benvonhandorf/esp32_sensor_board/hardware/USB4510-03-1-A_REVA/USB4510-03-1-A_REVA.step

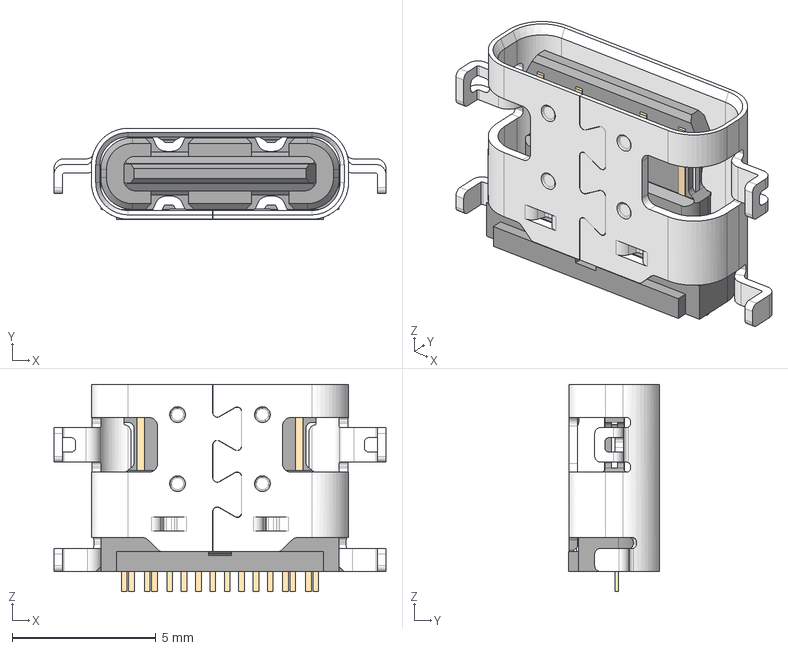
[picture p7: CAD file, 2024-07-11]
hardware/USB4510-03-1-A_REVA/USB4510-03-1-A_REVA.step
11.5 x 3.18 x 7.20 mm
