benvonhandorf/esp32_sensor_board/hardware/v0/esp32_sensor_board/info/esp32_sensor_board.pdf

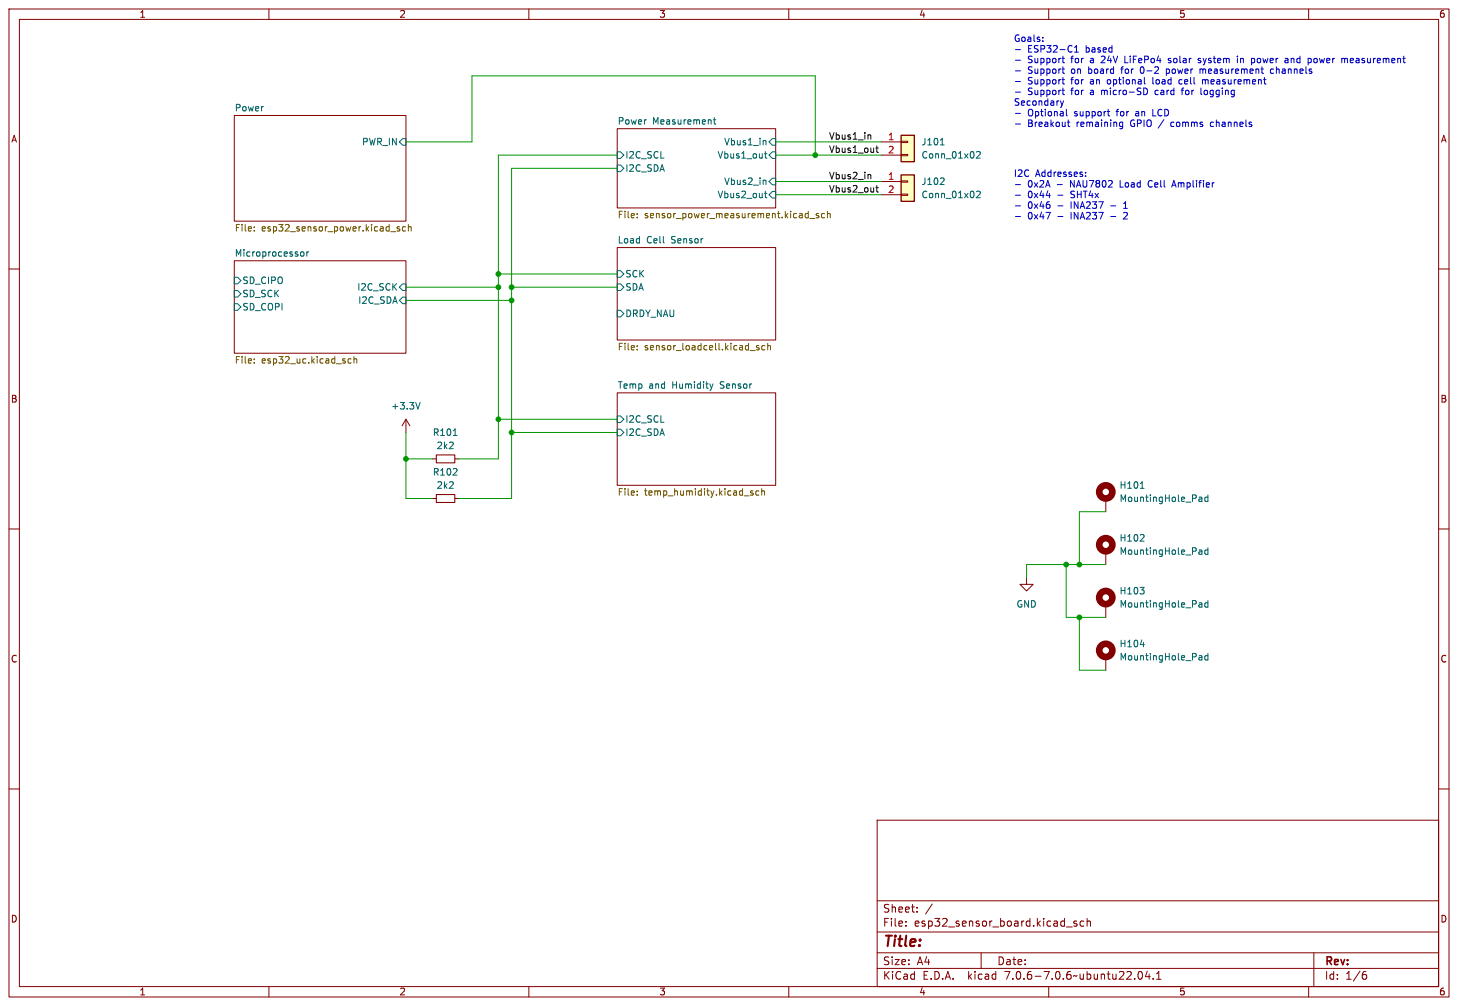
[picture p10: page 1]

I2C Addresses: - 0x2A - NAU7802 Load Cell Amplifier

Load Cell Sensor File: sensor_loadcell.kicad_sch

Id: 1/6 Title: File: esp32_sensor_board.kicad_sch Sheet: /

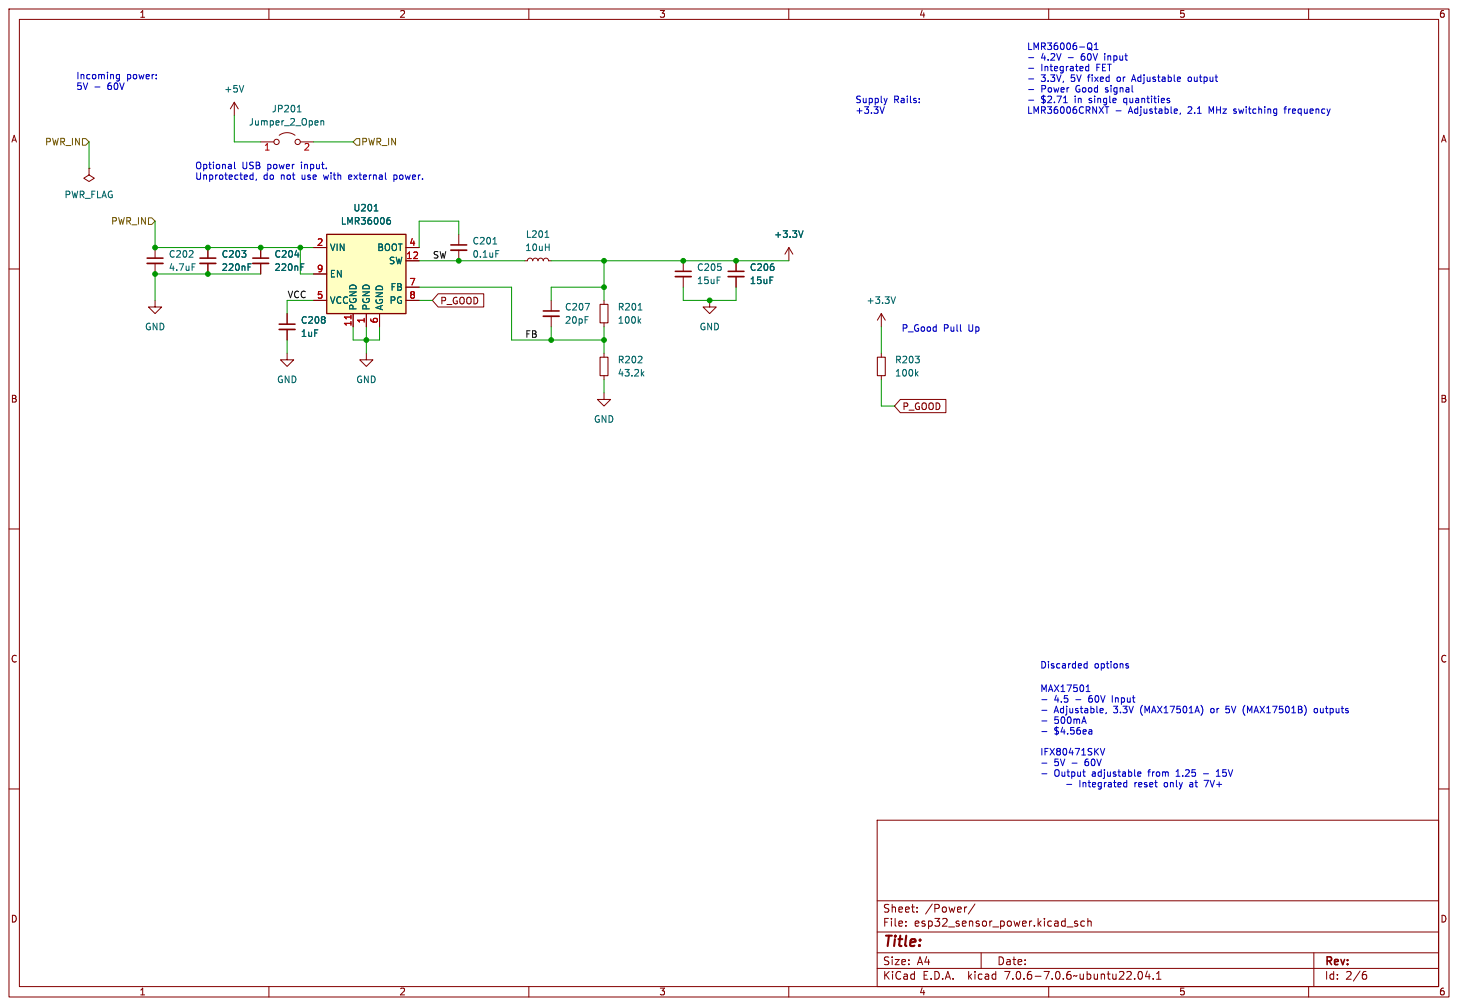
[picture p11: page 2]

1 PGND 11 SW 12 VIN 2 BOOT 4 VCC 5 AGND

Id: 2/6 Title: File: esp32_sensor_power.kicad_sch Sheet: /Power/

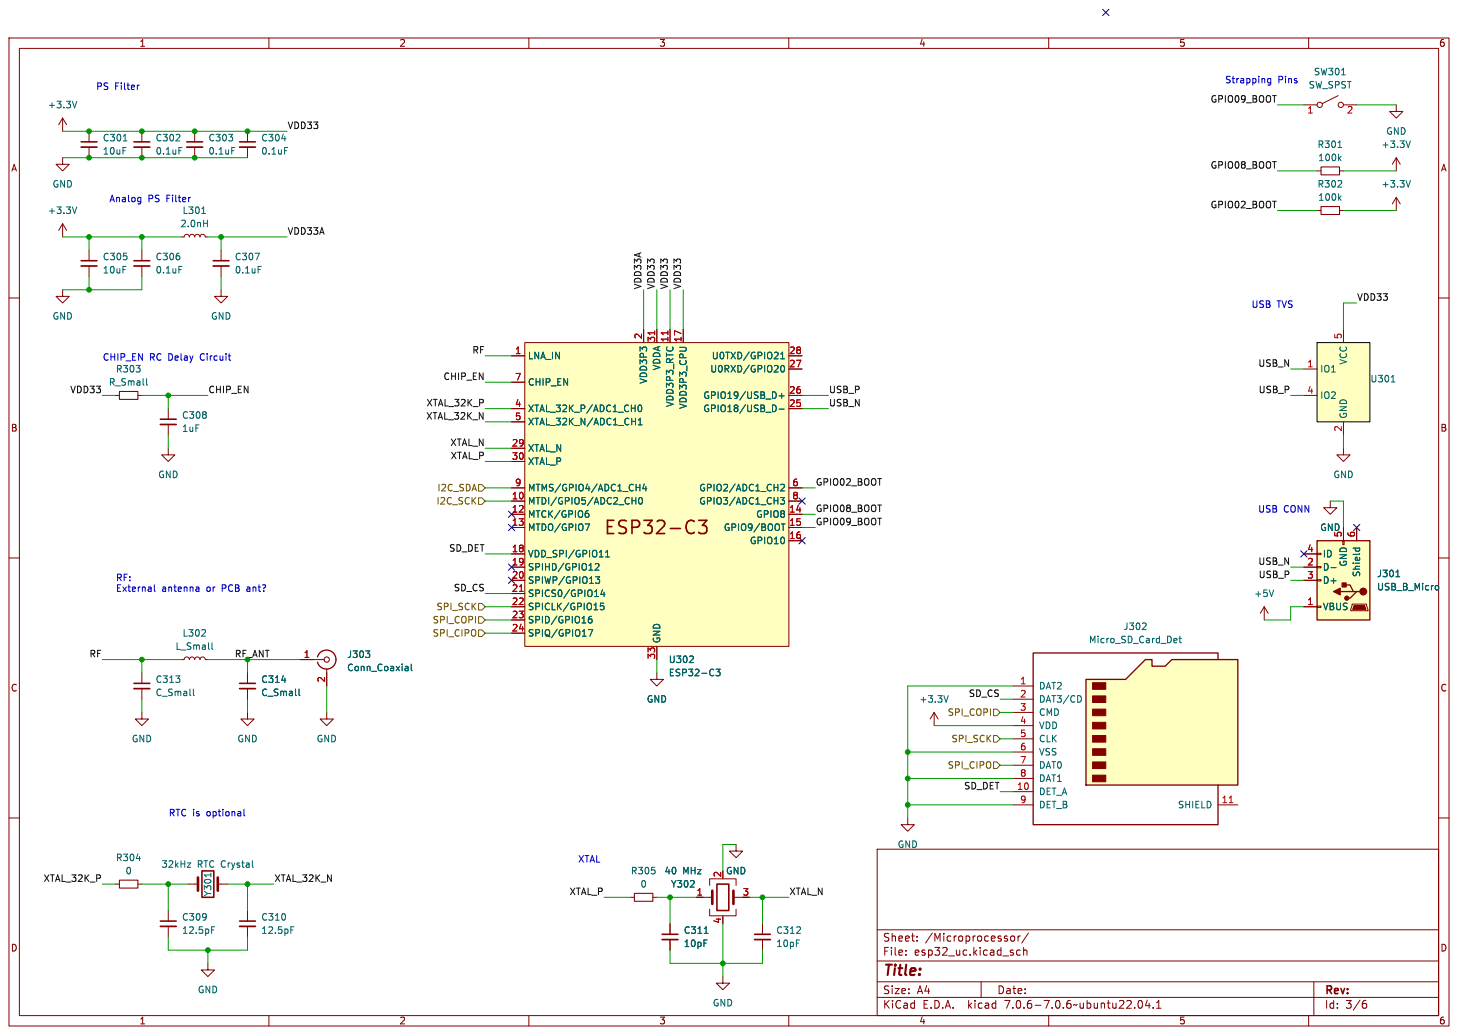
[picture p12: page 3]

2 SPIWP/GPIO13 20 SPICS0/GPIO14 21 SPICLK/GPIO15 22 SPID/GPIO16 23 SPIQ/GPIO17 24 GPIO18/USB_D- 25 GPIO19/USB_D+ 26 U0RXD/GPIO20 27 U0TXD/GPIO21 28 XTAL_N 29 XTAL_P 30 VDDA 31 GND 33 XTAL_32K_P/ADC1_CH0 4 XTAL_32K_N/ADC1_CH1 5 GPIO2/ADC1_CH2 6 CHIP_EN 7 GPIO3/ADC1_CH3 8 MTMS/GPIO4/ADC1_CH4 9 U302 ESP32-C3 GND

2 SPIWP/GPIO13 20 SPICS0/GPIO14 21 SPICLK/GPIO15 22 SPID/GPIO16 23 SPIQ/GPIO17 24 GPIO18/USB_D- 25 GPIO19/USB_D+ 26 U0RXD/GPIO20 27 U0TXD/GPIO21 28 XTAL_N 29 XTAL_P 30 VDDA 31 GND 33 XTAL_32K_P/ADC1_CH0 4 XTAL_32K_N/ADC1_CH1 5 GPIO2/ADC1_CH2 6 CHIP_EN 7 GPIO3/ADC1_CH3 8 MTMS/GPIO4/ADC1_CH4 9 GND

Id: 3/6 Title: File: esp32_uc.kicad_sch Sheet: /Microprocessor/

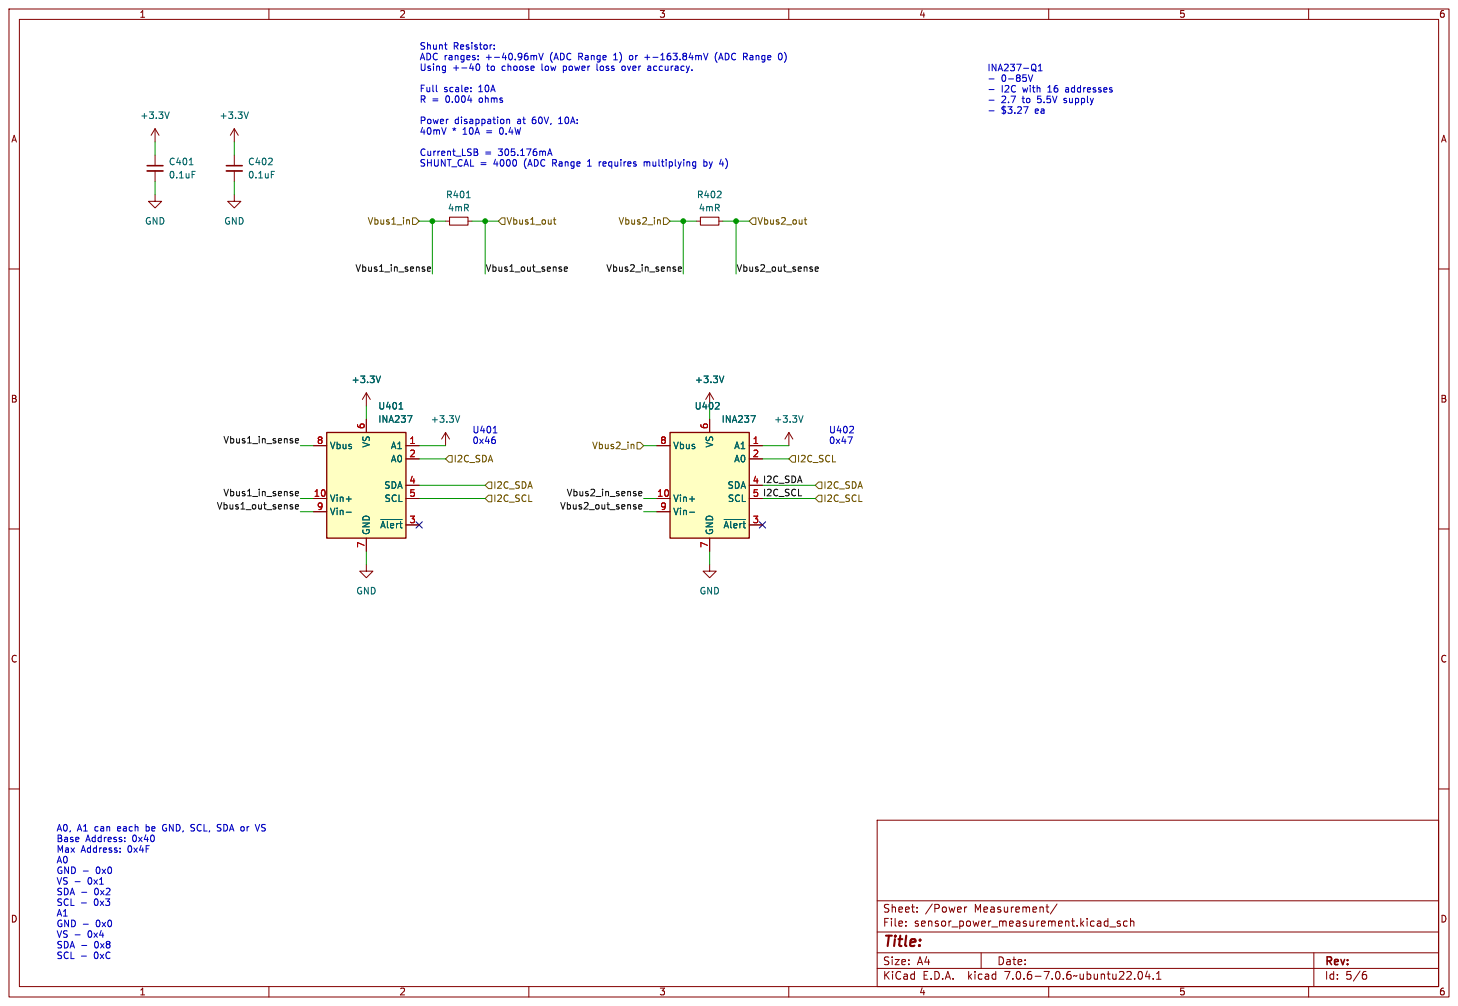
[picture p13: page 4]

0x47 A0, A1 can each be GND, SCL, SDA or VS

Base Address: 0x40 Max Address: 0x4F A0GND - 0x0 VS - 0x1 SDA - 0x2 SCL - 0x3 A1GND - 0x0 VS - 0x4 SDA - 0x8 SCL - 0xC

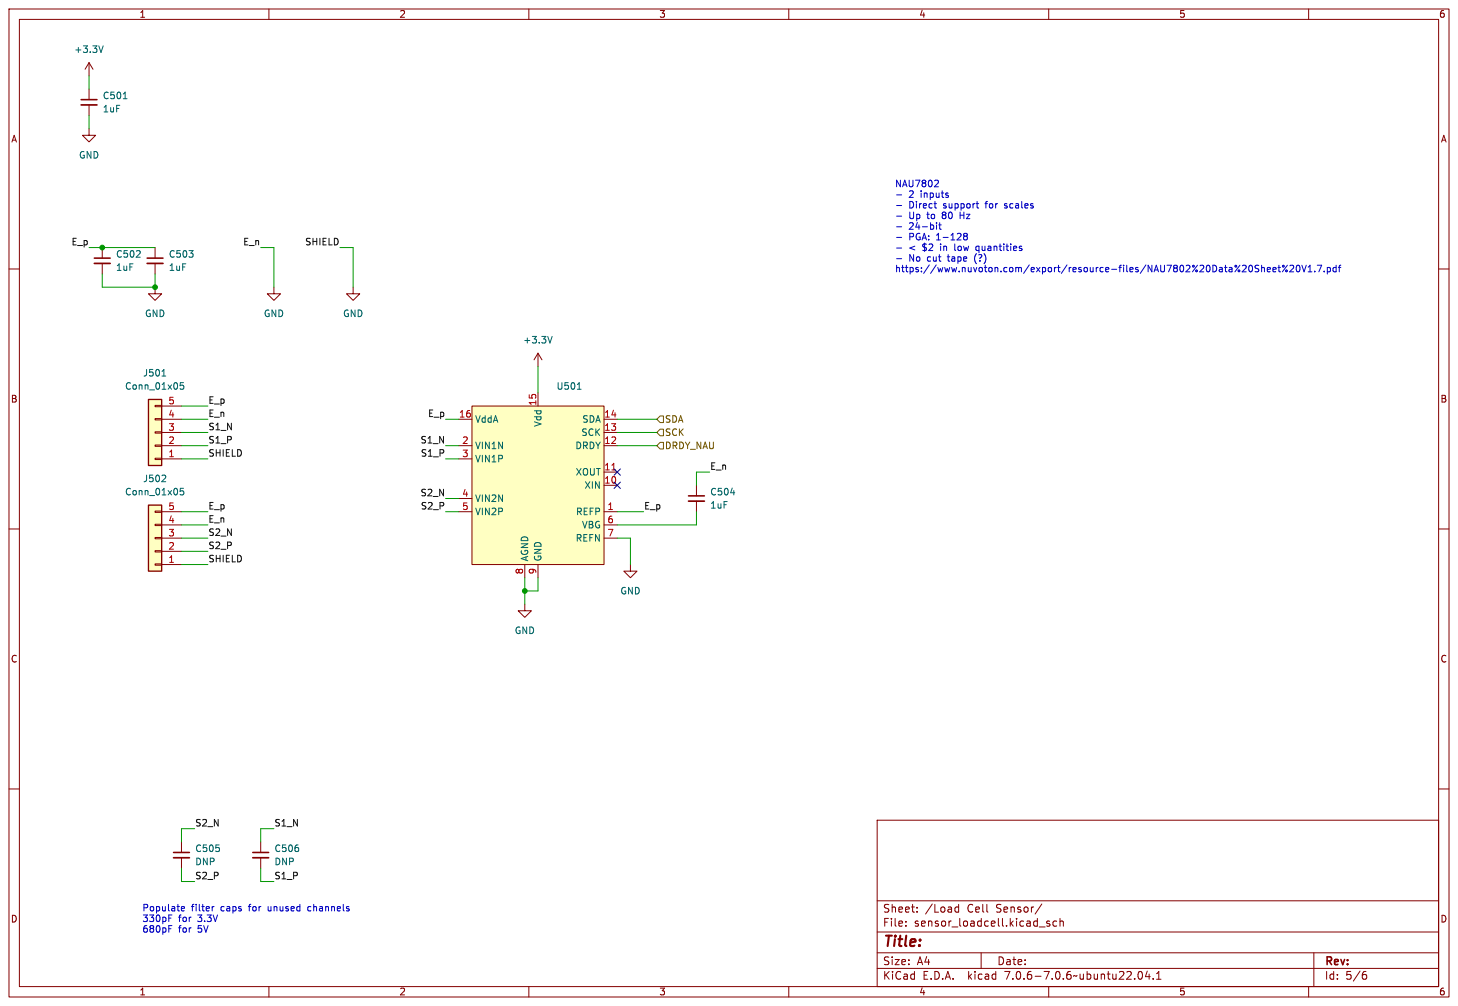
[picture p14: page 5]

NAU7802
- 2 inputs
- Direct support for scales
- 24-bit - PGA: 1-128

- < $2 in low quantities
- No cut tape (?)
https://www.nuvoton.com/export/resource-files/NAU7802%20Data%20Sheet%20V1.7.pdf

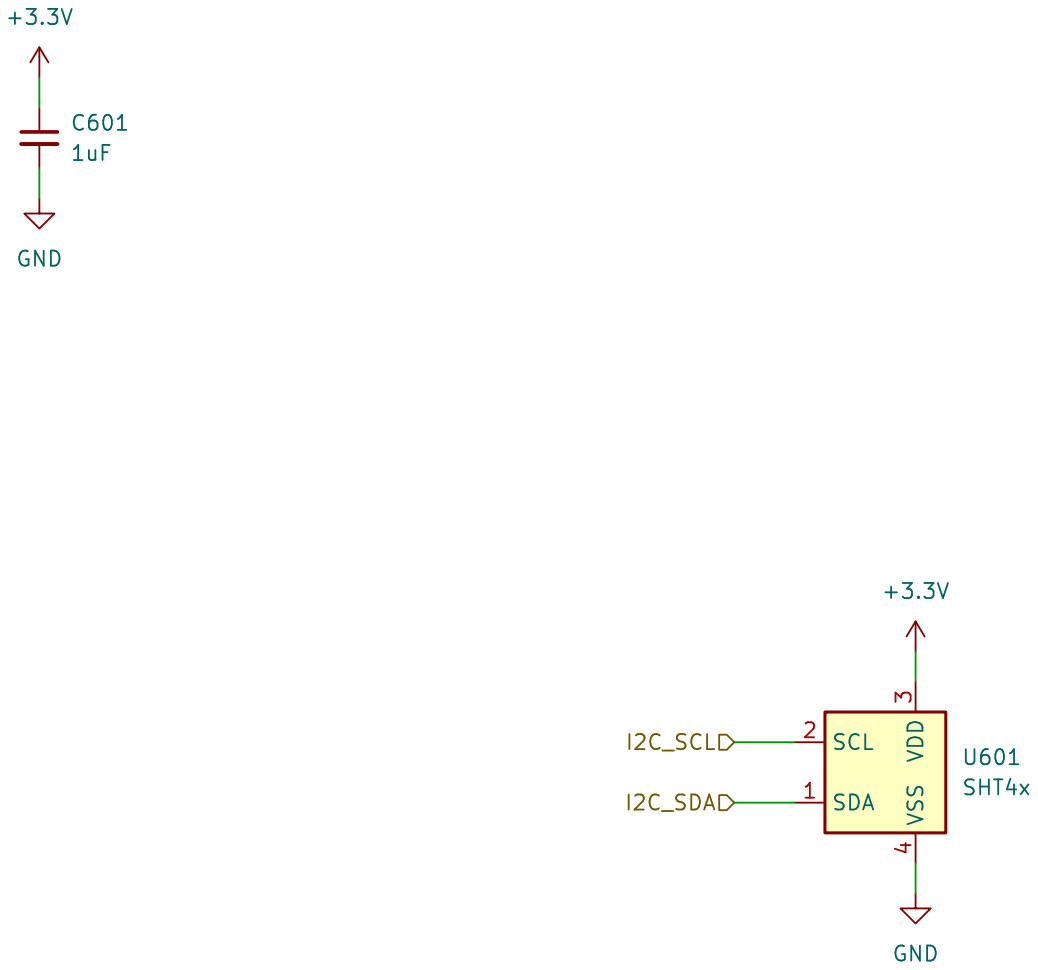
[picture p15: page 6]
