benvonhandorf/esp32_sensor_board/hardware/v1 - S3 - Mic Focus/pdm_mic_board_individual/pdm_mic_board_individual.kicad_pcb

## KiCad design hardware/v1 - S3 - Mic Focus/pdm_mic_board_individual/pdm_mic_board_individual.kicad_pcb (2026-09-26)

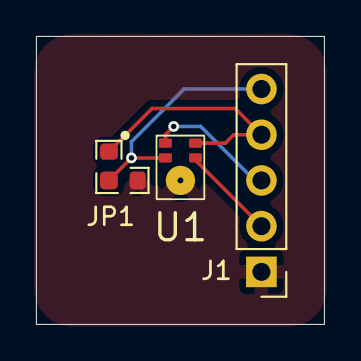
[picture p16: board pdm_mic_board_individual.kicad_pcb from above]

Board: 2 copper layers, 16.0 x 16.0 mm, 3 parts (0 on the bottom side), 5 nets.

Parts:
J1: Mic Conn; PinHeader_1x05_P2.54mm_Vertical
JP1: L/R; Jumper_Resistor_0603_2_Way
U1: Knowles_PDM_SMD_ThroughPort

Connections:
+3.3V: J1.4, JP1.1 (A), U1.5 (Vcc)
/Dout: J1.3, U1.1 (Dout)
/SCLK: J1.2, U1.4 (CLK)
/SEL: J1.5, JP1.2 (COM), U1.2 (SEL)
GND: J1.1, JP1.3 (B), U1.3 (GND)
