benvonhandorf/esp32_sensor_board/hardware/v1 - S3 - Mic Focus/s3_sensor_board/s3_sensor_board.kicad_pcb

## KiCad design hardware/v1 - S3 - Mic Focus/s3_sensor_board/s3_sensor_board.kicad_pcb (2026-09-26)

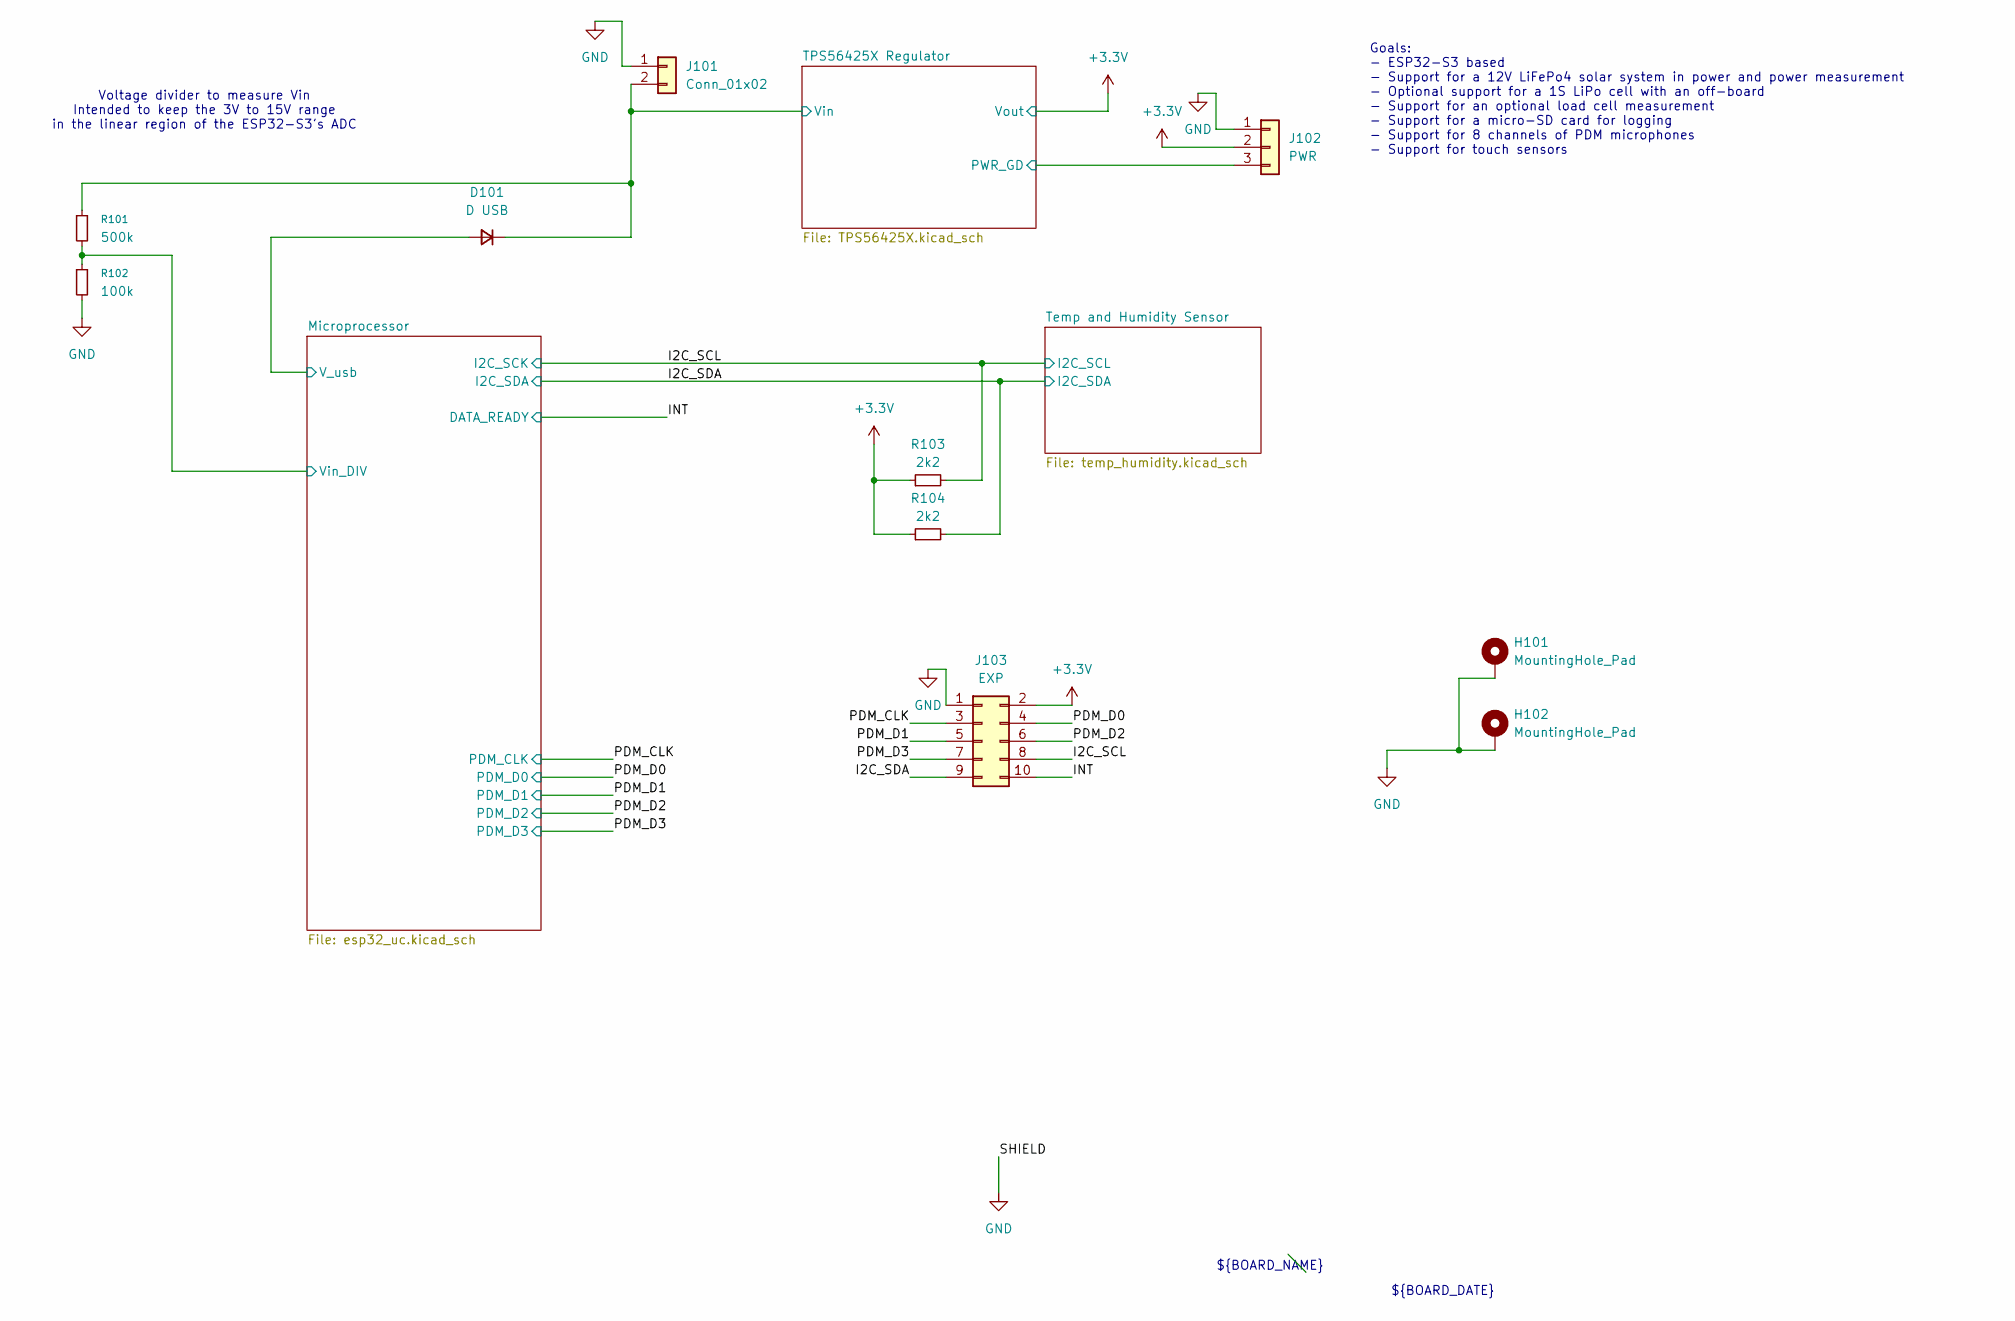
[picture p17: schematic s3_sensor_board.kicad_sch]

Parts:
D101: D USB; D_SOD-123
H101, H102: MountingHole_Pad; MountingHole_2.2mm_M2_DIN965_Pad
J101: Conn_01x02; PinHeader_1x02_P2.54mm_Vertical
J102: PWR; PinHeader_1x03_P2.54mm_Vertical
J103: EXP; IDC-Header_2x05_P2.54mm_Vertical
R101: 500k; R_0603_1608Metric
R102: 100k; R_0603_1608Metric
R103, R104: 2k2; R_0603_1608Metric

Connections:
+3.3V: J102.2, J103.2, R103.1, R104.1; also elsewhere on the board
/I2C_SCL: J103.8, R103.2; also elsewhere on the board
/I2C_SDA: J103.9, R104.2; also elsewhere on the board
/INT: J103.10; also elsewhere on the board
/Microprocessor/V_usb: D101.2 (A); also elsewhere on the board
/Microprocessor/Vin_DIV: R101.2, R102.1; also elsewhere on the board
/PDM_CLK: J103.3; also elsewhere on the board
/PDM_D0: J103.4; also elsewhere on the board
/PDM_D1: J103.5; also elsewhere on the board
/PDM_D2: J103.6; also elsewhere on the board
/PDM_D3: J103.7; also elsewhere on the board
/TPS56425X Regulator/PWR_GD: J102.3; also elsewhere on the board
/TPS56425X Regulator/Vin: D101.1 (K), J101.2, R101.1; also elsewhere on the board
GND: H101.1 (1_1), H102.1 (1_1), J101.1, J102.1, J103.1, R102.2; also elsewhere on the board

Notes on the sheet:
${BOARD_DATE}
Goals: - ESP32-S3 based - Support for a 12V LiFePo4 solar system in power and power measurement - Optional support for a 1S LiPo cell with an off-board - Support for an optional load cell measurement - Support for a micro-SD card for logging - Support for 8 channels of PDM microphones - Support for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
${BOARD_NAME}
Voltage divider to measure Vin Intended to keep the 3V to 15V range in the linear region of the ESP32-S3's ADC

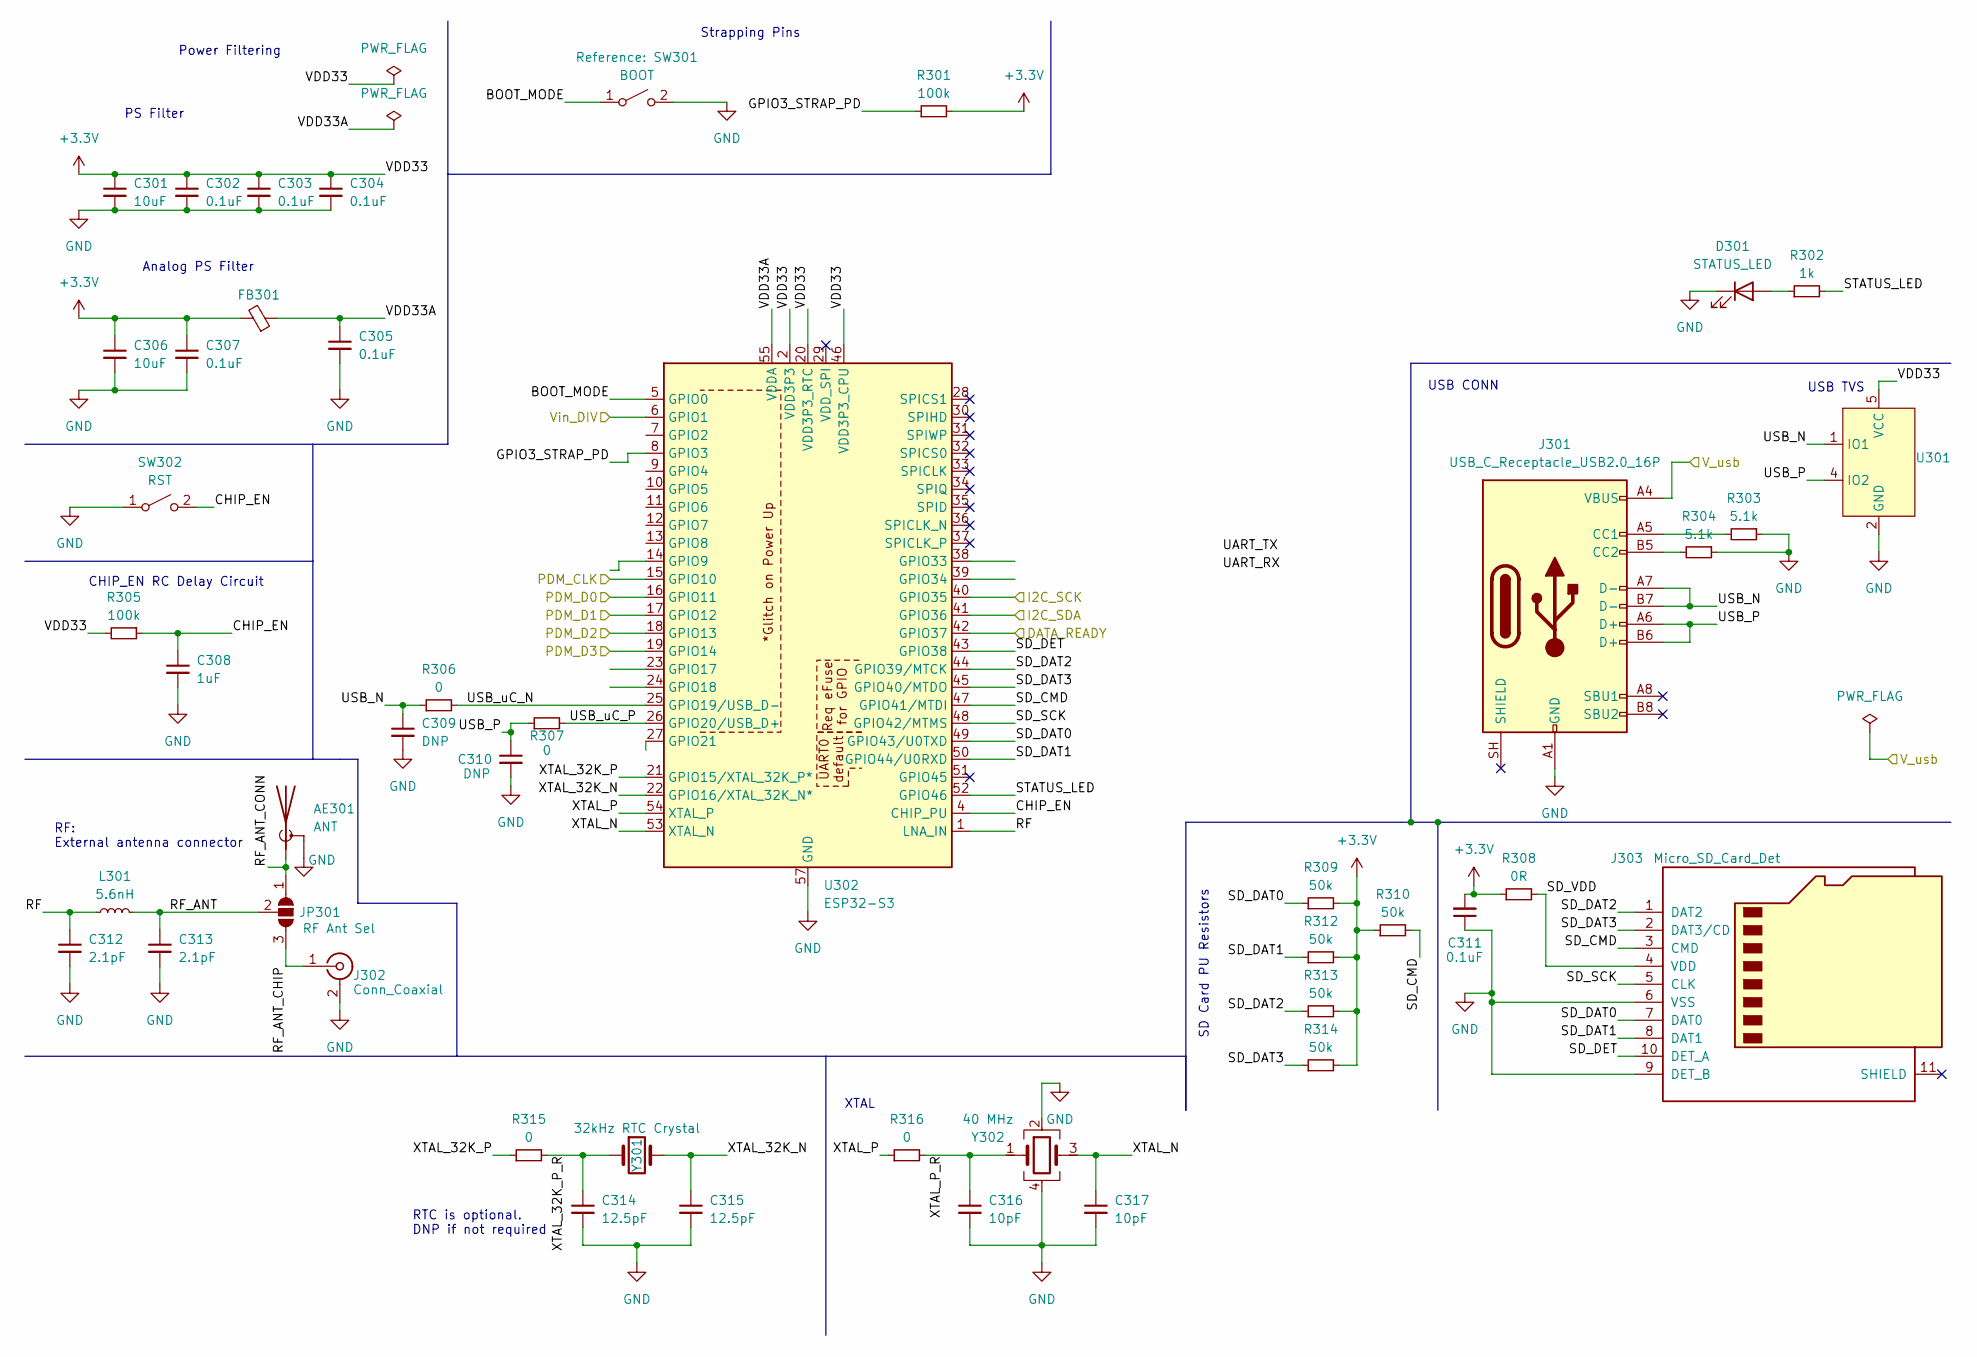
[picture p18: schematic esp32_uc.kicad_sch]

Parts:
AE301: ANT; ANT2012LL13R2400A
C301, C306: 10uF; C_0805_2012Metric
C302, C303, C304, C305, C307, C311: 0.1uF; C_0603_1608Metric
C308: 1uF; C_0805_2012Metric
C309, C310: DNP; C_0603_1608Metric
C312, C313: 2.1pF; C_0603_1608Metric
C314, C315: 12.5pF; C_0603_1608Metric
C316, C317: 10pF; C_0603_1608Metric
D301: STATUS_LED; LED_0805_2012Metric
FB301: R_0805_2012Metric
J301: USB_C_Receptacle_USB2.0_16P; USB_C_Receptacle_GCT_USB4085
J302: Conn_Coaxial; U.FL_Molex_MCRF_73412-0110_Vertical
J303: Micro_SD_Card_Det; MicroSD_Socket_Unbranded
JP301: RF Ant Sel; Jumper_Resistor_0603_2_Way
L301: 5.6nH; L_0603_1608Metric
R301, R305: 100k; R_0603_1608Metric
R302: 1k; R_0603_1608Metric
R303, R304: 5.1k; R_0603_1608Metric
R306, R307, R315, R316: 0; R_0603_1608Metric
R308: 0R; R_0603_1608Metric
R309, R310, R312, R313, R314: 50k; R_0603_1608Metric
SW301: BOOT; TacButton_SMD_4.0x3.0mm_SPST_NO_2P
SW302: RST; TacButton_SMD_4.0x3.0mm_SPST_NO_2P
U301: SOT-23-6
U302: ESP32-S3; QFN-56-1EP_7x7mm_P0.4mm_EP4x4mm
Y301: 32kHz RTC Crystal; Crystal_SMD_3215-2Pin_3.2x1.5mm
Y302: 40 MHz; Crystal_SMD_2016-4Pin_2.0x1.6mm

Connections:
+3.3V: C301.1, C302.1, C303.1, C304.1, C306.1, C307.1, C311.2, FB301.2, R301.2, R305.2, R308.1, R309.2, R310.1, R312.2, R313.2, R314.2, U301.5 (VCC), U302.2 (VDD3P3), U302.3 (VDD3P3), U302.20 (VDD3P3_RTC), U302.46 (VDD3P3_CPU); also elsewhere on the board
/I2C_SCL: U302.40 (GPIO35); also elsewhere on the board
/I2C_SDA: U302.41 (GPIO36); also elsewhere on the board
/INT: U302.42 (GPIO37); also elsewhere on the board
/Microprocessor/BOOT_MODE: SW301.1 (A), U302.5 (GPIO0)
/Microprocessor/CHIP_EN: C308.1, R305.1, SW302.2 (B), U302.4 (CHIP_PU)
/Microprocessor/GPIO3_STRAP_PD: R301.1, U302.8 (GPIO3)
/Microprocessor/RF: C312.1, L301.1, U302.1 (LNA_IN)
/Microprocessor/RF_ANT: C313.1, JP301.2 (C), L301.2
/Microprocessor/RF_ANT_CHIP: J302.1 (In), JP301.3 (B)
/Microprocessor/RF_ANT_CONN: AE301.1 (A), JP301.1 (A)
/Microprocessor/SD_CMD: J303.3 (CMD), R310.2, U302.47 (GPIO41/MTDI)
/Microprocessor/SD_DAT0: J303.7 (DAT0), R309.1, U302.49 (GPIO43/U0TXD)
/Microprocessor/SD_DAT1: J303.8 (DAT1), R312.1, U302.50 (GPIO44/U0RXD)
/Microprocessor/SD_DAT2: J303.1 (DAT2), R313.1, U302.44 (GPIO39/MTCK)
/Microprocessor/SD_DAT3: J303.2 (DAT3/CD), R314.1, U302.45 (GPIO40/MTDO)
/Microprocessor/SD_DET: J303.10 (DET_A), U302.43 (GPIO38)
/Microprocessor/SD_SCK: J303.5 (CLK), U302.48 (GPIO42/MTMS)
/Microprocessor/SD_VDD: J303.4 (VDD), R308.2
/Microprocessor/STATUS_LED: R302.2, U302.52 (GPIO46)
/Microprocessor/USB_N: C309.1, J301.A7 (D-), J301.B7 (D-), R306.1, U301.1 (IO1)
/Microprocessor/USB_P: C310.1, J301.A6 (D+), J301.B6 (D+), R307.1, U301.4 (IO2)
/Microprocessor/USB_uC_N: R306.2, U302.25 (GPIO19/USB_D-)
/Microprocessor/USB_uC_P: R307.2, U302.26 (GPIO20/USB_D+)
/Microprocessor/VDD33A: C305.1, FB301.1, U302.55 (VDDA), U302.56 (VDDA)
/Microprocessor/V_usb: J301.A4 (VBUS), J301.A9 (VBUS), J301.B4 (VBUS), J301.B9 (VBUS); also elsewhere on the board
/Microprocessor/Vin_DIV: U302.6 (GPIO1); also elsewhere on the board
/Microprocessor/XTAL_32K_N: C315.1, U302.22 (GPIO16/XTAL_32K_N*), Y301.2
/Microprocessor/XTAL_32K_P: R315.1, U302.21 (GPIO15/XTAL_32K_P*)
/Microprocessor/XTAL_32K_P_R: C314.1, R315.2, Y301.1
/Microprocessor/XTAL_N: C317.1, U302.53 (XTAL_N), Y302.3
/Microprocessor/XTAL_P: R316.1, U302.54 (XTAL_P)
/Microprocessor/XTAL_P_R: C316.1, R316.2, Y302.1
/PDM_CLK: U302.15 (GPIO10); also elsewhere on the board
/PDM_D0: U302.16 (GPIO11); also elsewhere on the board
/PDM_D1: U302.17 (GPIO12); also elsewhere on the board
/PDM_D2: U302.18 (GPIO13); also elsewhere on the board
/PDM_D3: U302.19 (GPIO14); also elsewhere on the board
GND: AE301.2 (GND), C301.2, C302.2, C303.2, C304.2, C305.2, C306.2, C307.2, C308.2, C309.2, C310.2, C311.1, C312.2, C313.2, C314.2, C315.2, C316.2, C317.2, D301.1 (K), J301.A1 (GND), J301.A12 (GND), J301.B1 (GND), J301.B12 (GND), J302.2 (Ext), J303.6 (VSS), J303.9 (DET_B), R303.1, R304.1, SW301.2 (B), SW302.1 (A), U301.2 (GND), U302.57 (GND), Y302.2, Y302.4; also elsewhere on the board
unnamed: D301.2 (A), R302.1
unnamed: J301.A5 (CC1), R303.2
unnamed: J301.B5 (CC2), R304.2

Notes on the sheet:
CHIP_EN RC Delay Circuit
Analog PS Filter
SD Card PU Resistors
XTAL
USB CONN
RTC is optional. DNP if not required
USB TVS
Strapping Pins
Power Filtering
PS Filter
RF: External antenna connector

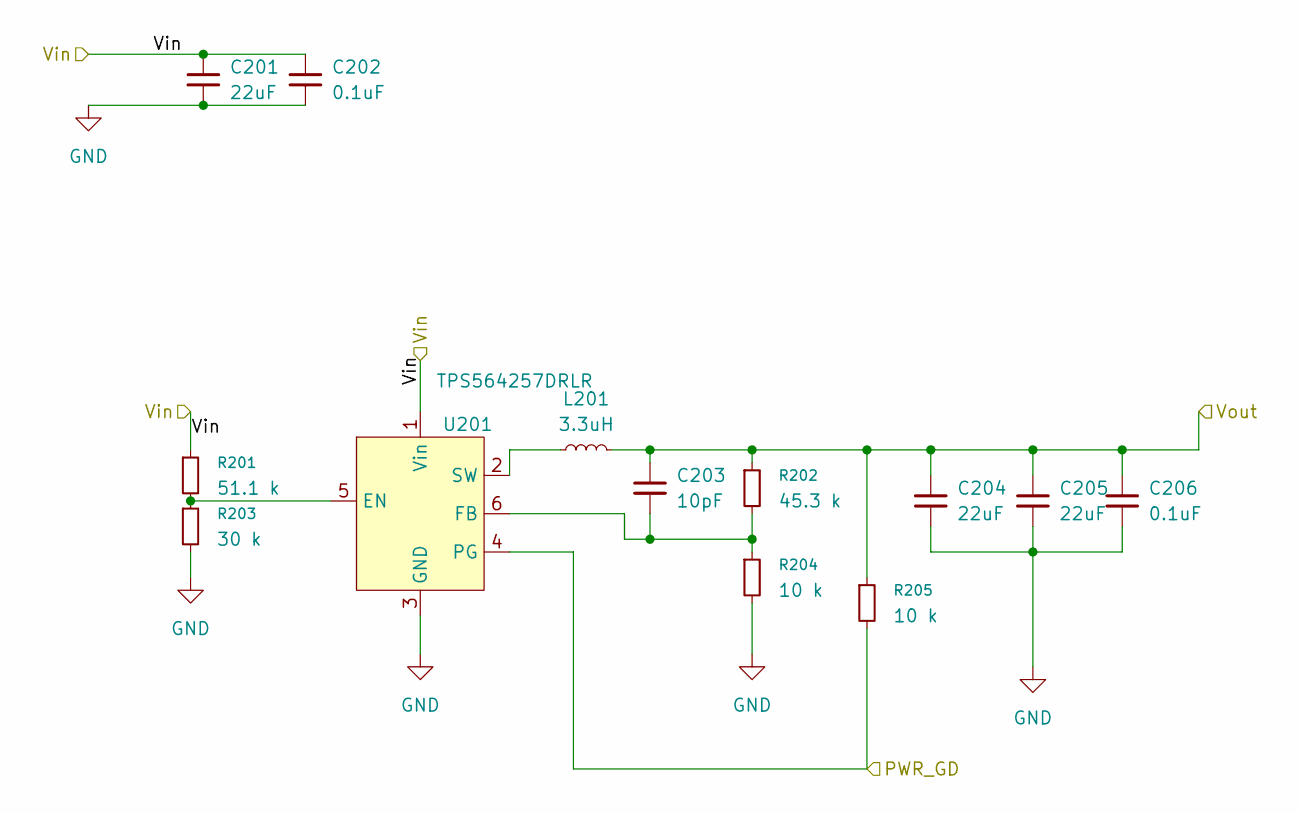
[picture p19: schematic TPS56425X.kicad_sch]

Parts:
C201, C204, C205: 22uF; C_0805_2012Metric; MPN GRM21BR61E226ME44L
C202, C206: 0.1uF; C_0603_1608Metric
C203: 10pF; C_0805_2012Metric
L201: 3.3uH; L_Taiyo-Yuden_MD-2020
R201: 51.1 k; R_0603_1608Metric
R202: 45.3 k; R_0603_1608Metric; MPN RC0603FR-0745K3L
R203: 30 k; R_0603_1608Metric
R204, R205: 10 k; R_0603_1608Metric
U201: TPS564257DRLR; SOT-563

Connections:
+3.3V: C203.1, C204.1, C205.1, C206.1, L201.2, R202.1, R205.1; also elsewhere on the board
/TPS56425X Regulator/PWR_GD: R205.2, U201.4 (PG); also elsewhere on the board
/TPS56425X Regulator/Vin: C201.1, C202.1, R201.1, U201.1 (Vin); also elsewhere on the board
GND: C201.2, C202.2, C204.2, C205.2, C206.2, R203.2, R204.2, U201.3 (GND); also elsewhere on the board
unnamed: R201.2, R203.1, U201.5 (EN)
unnamed: C203.2, R202.2, R204.1, U201.6 (FB)
unnamed: L201.1, U201.2 (SW)

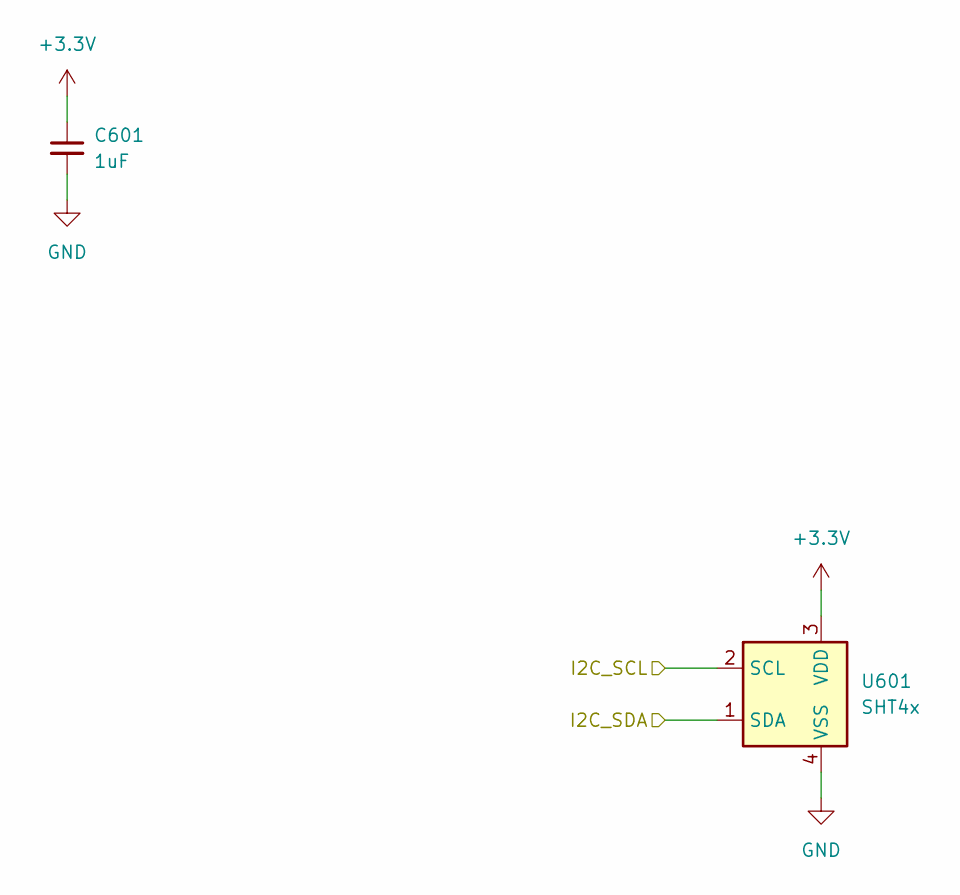
[picture p20: schematic temp_humidity.kicad_sch]

Parts:
C601: 1uF; C_0805_2012Metric
U601: SHT4x; Sensirion_DFN-4_1.5x1.5mm_P0.8mm_SHT4x_NoCentralPad

Connections:
unnamed: C601.1, U601.3 (VDD)
unnamed: C601.2, U601.4 (VSS)

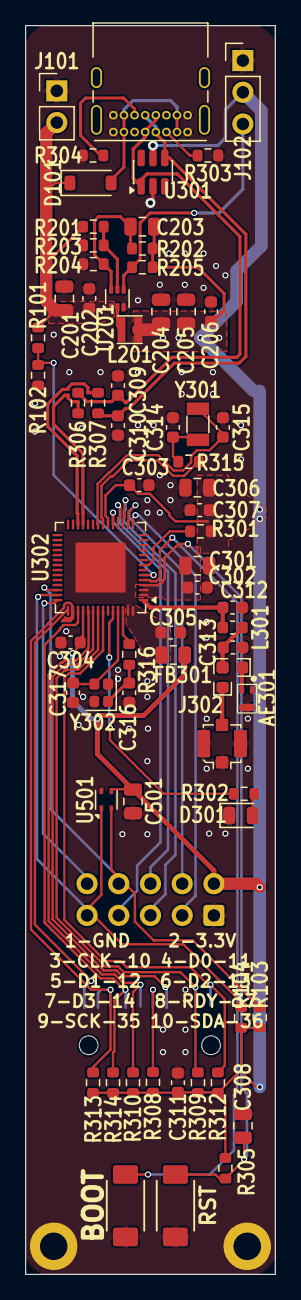
[picture p21: board s3_sensor_board.kicad_pcb from above]

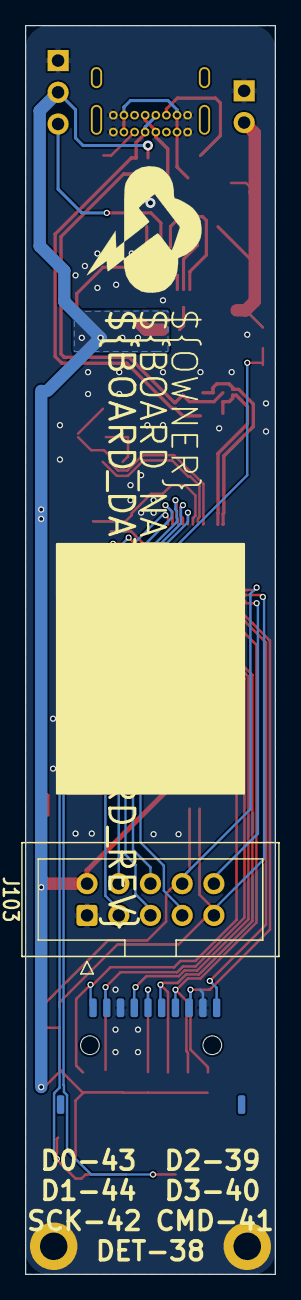
[picture p22: board s3_sensor_board.kicad_pcb from below]

Board: 4 copper layers, 20.0 x 100.0 mm, 71 parts (2 on the bottom side), 47 nets.

Other parts of the board:
C501: 1uF; C_0805_2012Metric
U501: SHT4x; Sensirion_DFN-4_1.5x1.5mm_P0.8mm_SHT4x_NoCentralPad

Their connections:
+3.3V: C501.1, U501.3 (VDD); also elsewhere on the board
/I2C_SCL: U501.2 (SCL); also elsewhere on the board
/I2C_SDA: U501.1 (SDA); also elsewhere on the board
GND: C501.2, U501.4 (VSS); also elsewhere on the board
