benvonhandorf/esp32_sensor_board/hardware/v1 - S3 - Mic Focus/loadcell_fanout/loadcell_fanout.kicad_pcb

## KiCad design hardware/v1 - S3 - Mic Focus/loadcell_fanout/loadcell_fanout.kicad_pcb (2026-09-26)

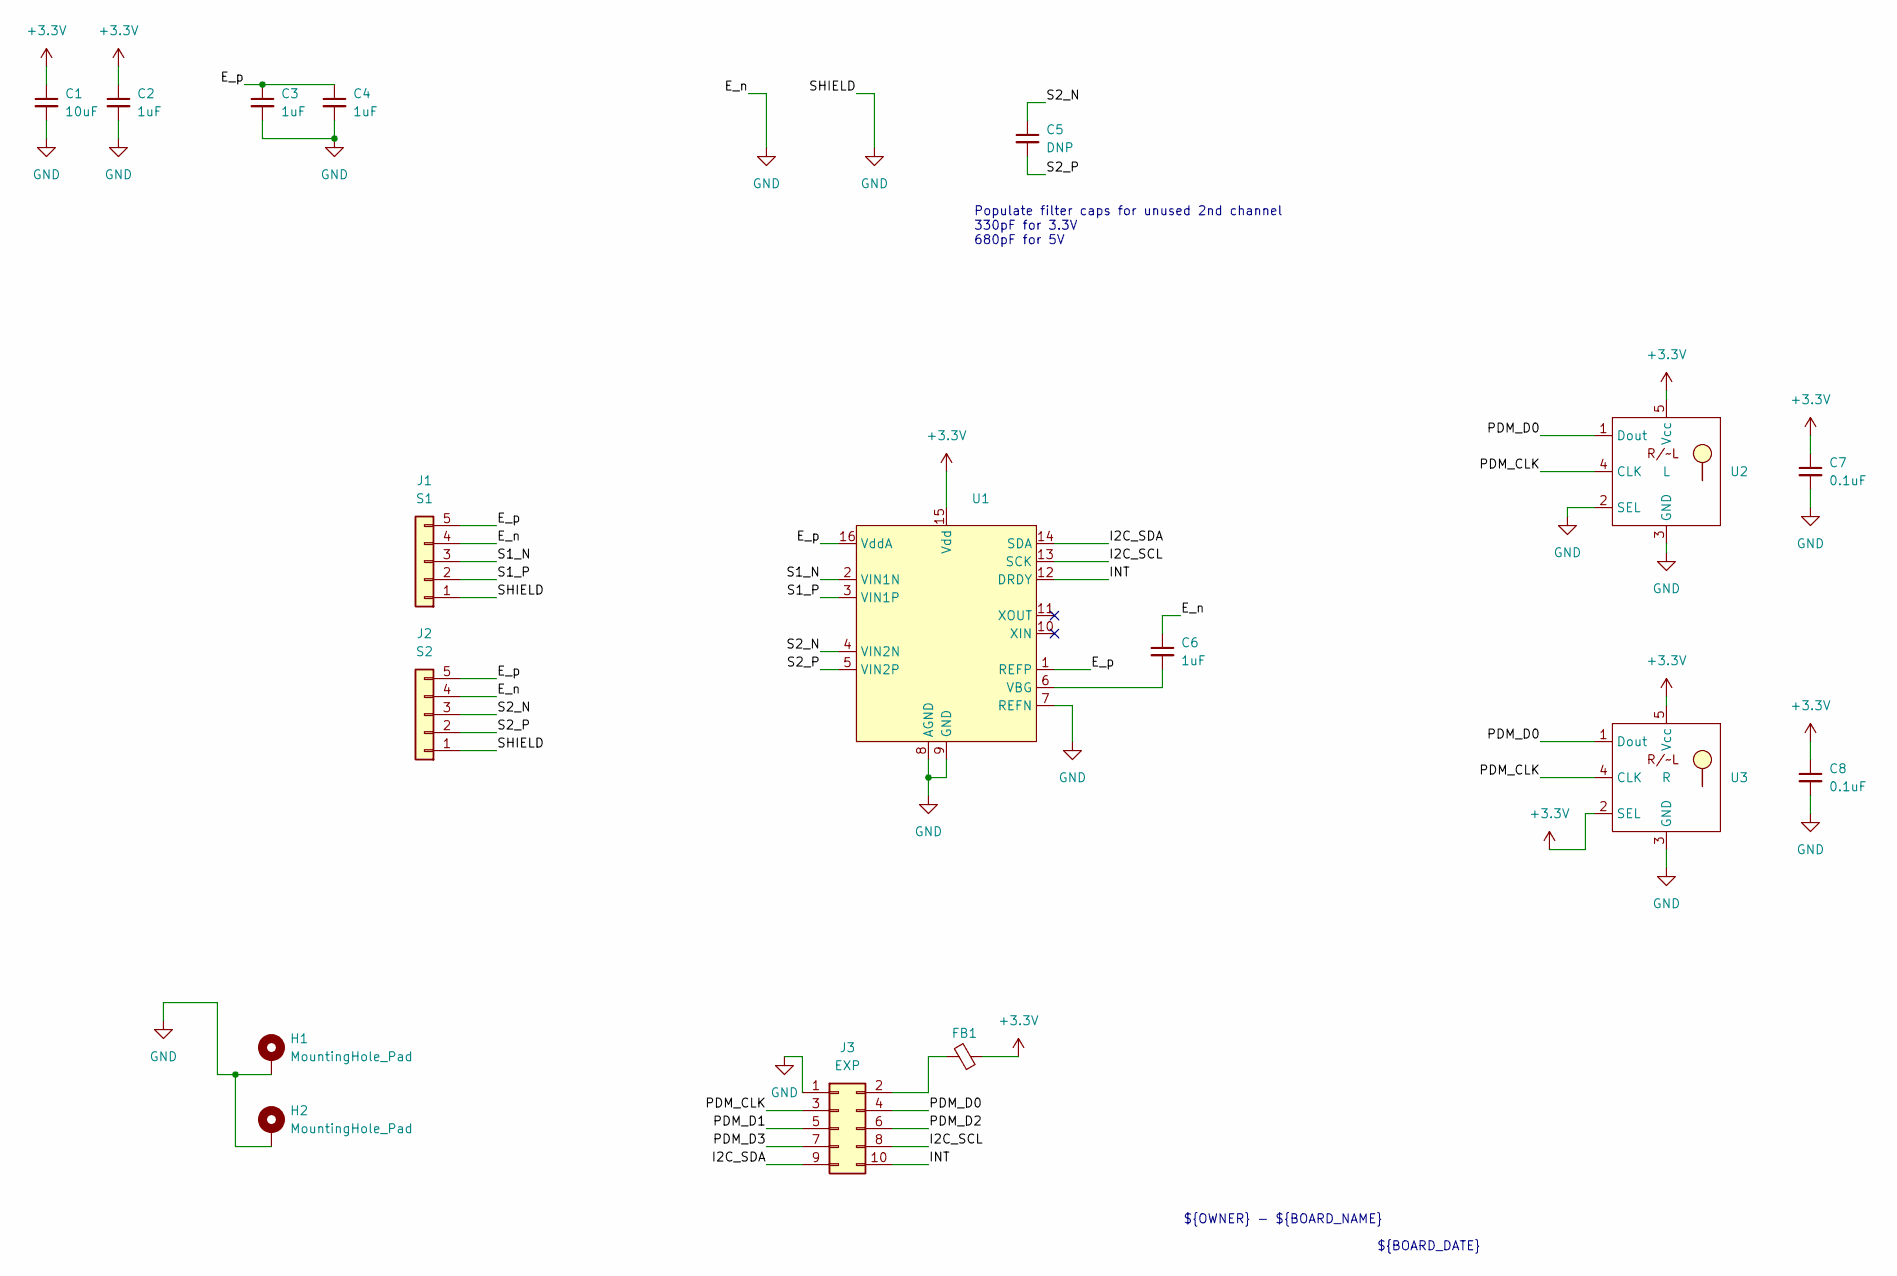
[picture p23: schematic loadcell_fanout.kicad_sch]

Parts:
C1: 10uF; C_0805_2012Metric
C2, C3, C4, C6: 1uF; C_0805_2012Metric
C5: DNP; C_0805_2012Metric
C7, C8: 0.1uF; C_0603_1608Metric
FB1: R_0805_2012Metric
H1, H2: MountingHole_Pad; MountingHole_2.2mm_M2_DIN965_Pad
J1: S1; PinHeader_1x05_P2.54mm_Vertical
J2: S2; PinHeader_1x05_P2.54mm_Vertical
J3: EXP; Conn_IDC_Female_Board_Mount_02x05_Abomination
U1: SOIC-16_3.9x9.9mm_P1.27mm
U2: L; Knowles_PDM_SMD_ThroughPort
U3: R; Knowles_PDM_SMD_ThroughPort

Connections:
+3.3V: C1.1, C2.1, C7.1, C8.1, FB1.1, U1.15 (Vdd), U2.5 (Vcc), U3.2 (SEL), U3.5 (Vcc)
/E_p: C3.1, C4.1, J1.5, J2.5, U1.1 (REFP), U1.16 (VddA)
/I2C_SCL: J3.8, U1.13 (SCK)
/I2C_SDA: J3.9, U1.14 (SDA)
/INT: J3.10, U1.12 (DRDY)
/PDM_CLK: J3.3, U2.4 (CLK), U3.4 (CLK)
/PDM_D0: J3.4, U2.1 (Dout), U3.1 (Dout)
/PDM_D1: J3.5
/PDM_D2: J3.6
/PDM_D3: J3.7
/S1_N: J1.3, U1.2 (VIN1N)
/S1_P: J1.2, U1.3 (VIN1P)
/S2_N: C5.1, J2.3, U1.4 (VIN2N)
/S2_P: C5.2, J2.2, U1.5 (VIN2P)
GND: C1.2, C2.2, C3.2, C4.2, C6.1, C7.2, C8.2, H1.1 (1_1), H2.1 (1_1), J1.1, J1.4, J2.1, J2.4, J3.1, U1.7 (REFN), U1.8 (AGND), U1.9 (GND), U2.2 (SEL), U2.3 (GND), U3.3 (GND)
unnamed: FB1.2, J3.2
unnamed: C6.2, U1.6 (VBG)

Notes on the sheet:
Populate filter caps for unused 2nd channel 330pF for 3.3V 680pF for 5V
${OWNER} - ${BOARD_NAME}
${BOARD_DATE}

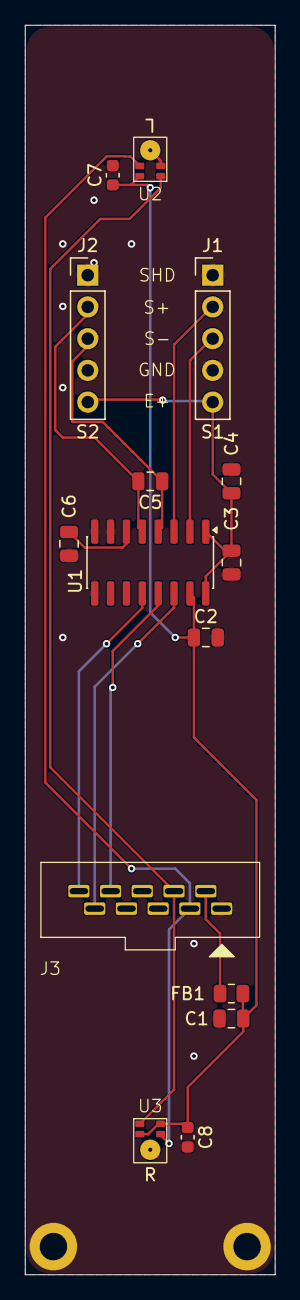
[picture p24: board loadcell_fanout.kicad_pcb from above]

Board: 4 copper layers, 20.0 x 100.0 mm, 17 parts (0 on the bottom side), 14 nets.
