benvonhandorf/esp32_sensor_board/hardware/v1 - S3 - Mic Focus/pdm_fanout/pdm_fanout.kicad_pcb

## KiCad design hardware/v1 - S3 - Mic Focus/pdm_fanout/pdm_fanout.kicad_pcb (2026-09-26)

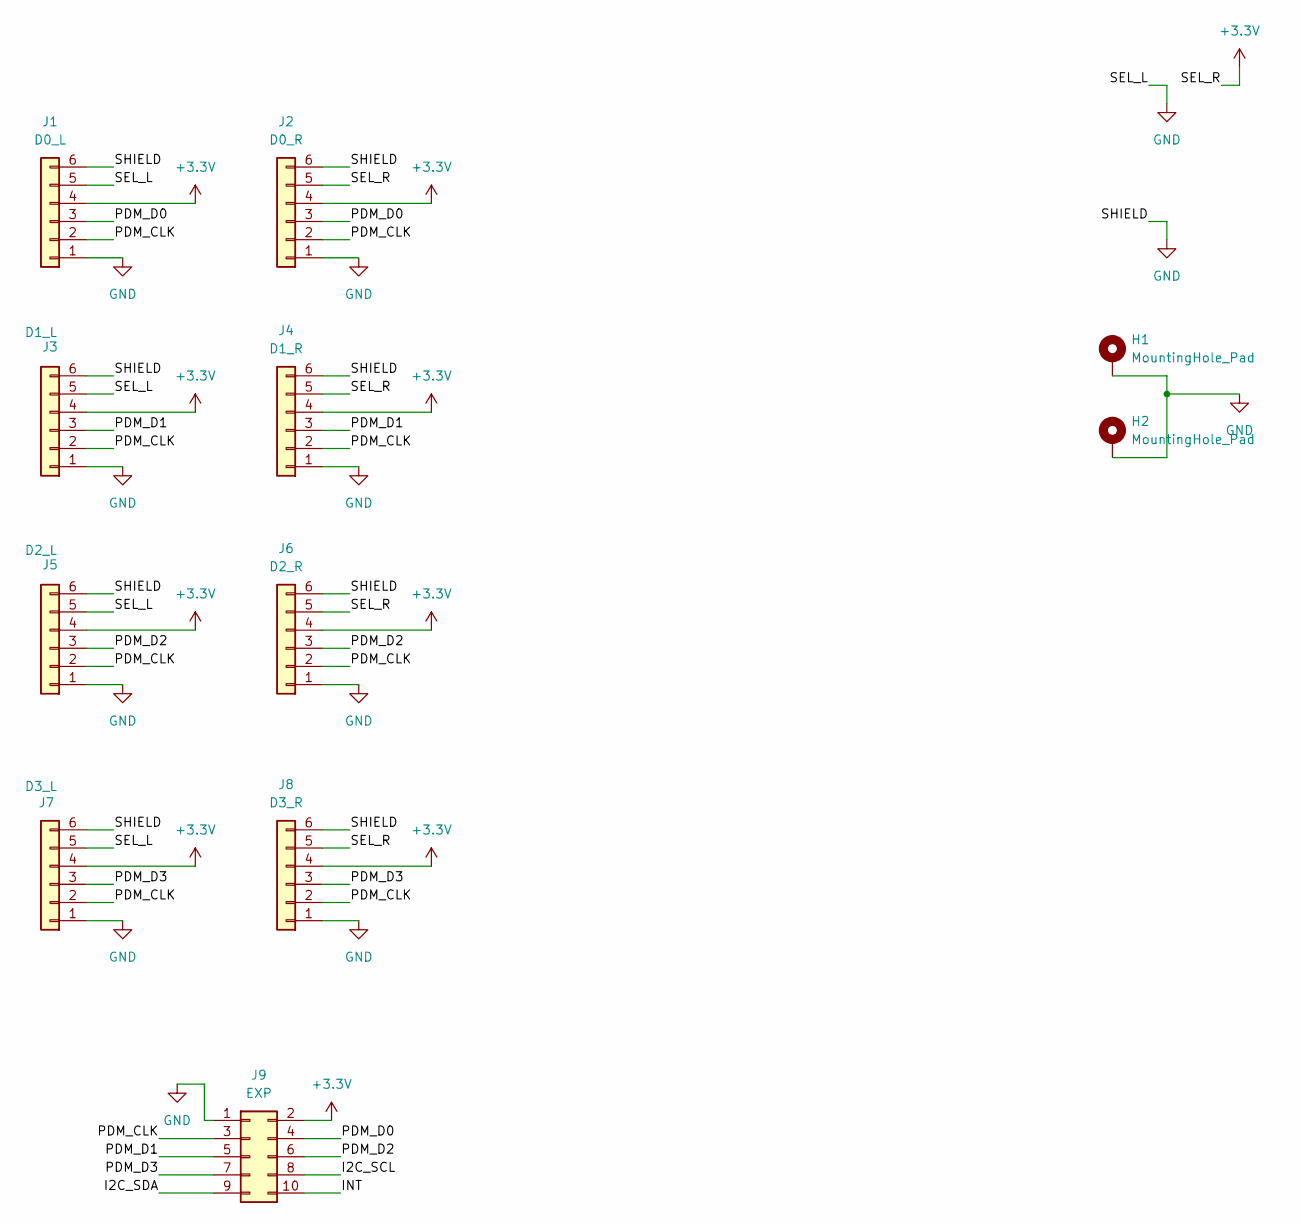
[picture p25: schematic pdm_fanout.kicad_sch]

Parts:
H1, H2: MountingHole_Pad; MountingHole_2.2mm_M2_DIN965_Pad
J1: D0_L; PinHeader_1x06_P2.54mm_Vertical
J2: D0_R; PinHeader_1x06_P2.54mm_Vertical
J3: D1_L; PinHeader_1x06_P2.54mm_Vertical
J4: D1_R; PinHeader_1x06_P2.54mm_Vertical
J5: D2_L; PinHeader_1x06_P2.54mm_Vertical
J6: D2_R; PinHeader_1x06_P2.54mm_Vertical
J7: D3_L; PinHeader_1x06_P2.54mm_Vertical
J8: D3_R; PinHeader_1x06_P2.54mm_Vertical
J9: EXP; Conn_IDC_Female_Board_Mount_02x05_Abomination

Connections:
+3.3V: J1.4, J2.4, J2.5, J3.4, J4.4, J4.5, J5.4, J6.4, J6.5, J7.4, J8.4, J8.5, J9.2
/I2C_SCL: J9.8
/I2C_SDA: J9.9
/INT: J9.10
/PDM_CLK: J1.2, J2.2, J3.2, J4.2, J5.2, J6.2, J7.2, J8.2, J9.3
/PDM_D0: J1.3, J2.3, J9.4
/PDM_D1: J3.3, J4.3, J9.5
/PDM_D2: J5.3, J6.3, J9.6
/PDM_D3: J7.3, J8.3, J9.7
GND: H1.1 (1_1), H2.1 (1_1), J1.1, J1.5, J1.6, J2.1, J2.6, J3.1, J3.5, J3.6, J4.1, J4.6, J5.1, J5.5, J5.6, J6.1, J6.6, J7.1, J7.5, J7.6, J8.1, J8.6, J9.1

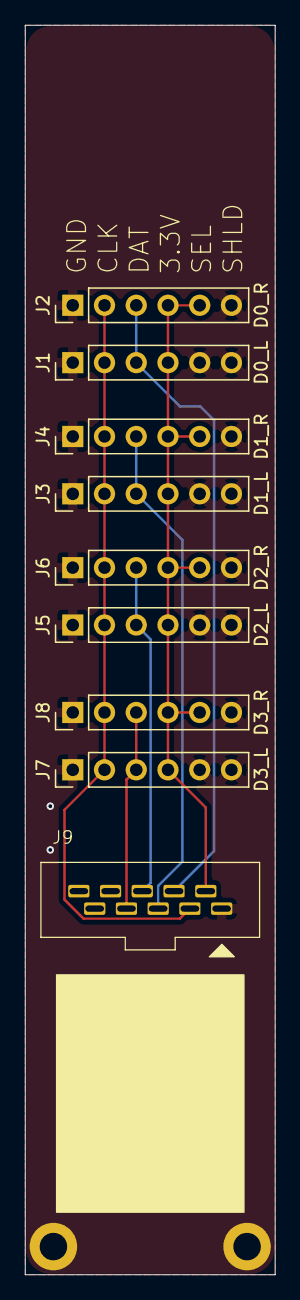
[picture p26: board pdm_fanout.kicad_pcb from above]

Board: 2 copper layers, 20.0 x 100.0 mm, 11 parts (0 on the bottom side), 7 nets.
