benvonhandorf/esp32_sensor_board/hardware/v0/esp32_sensor_board/esp32_sensor_board.kicad_pcb

## KiCad design hardware/v0/esp32_sensor_board/esp32_sensor_board.kicad_pcb (2025-01-12)

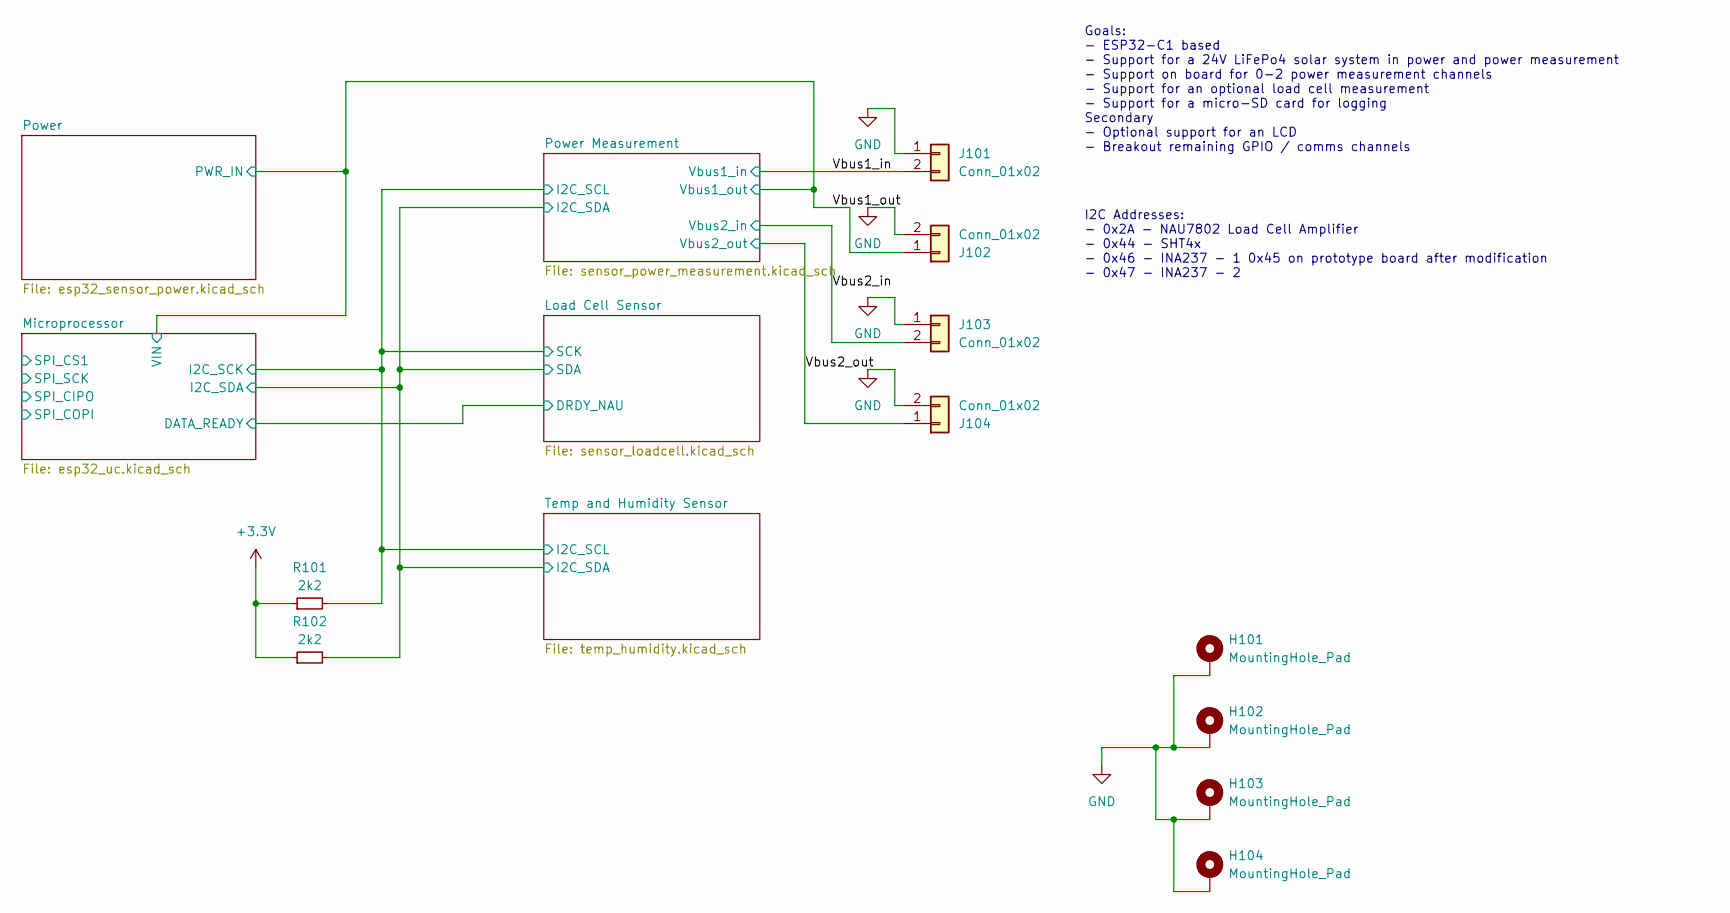
[picture p27: schematic esp32_sensor_board.kicad_sch]

Parts:
H101, H102, H103, H104: MountingHole_Pad; MountingHole_3.2mm_M3_DIN965_Pad
J101, J102, J103, J104: Conn_01x02; PhoenixContact_MSTBA_2,5_2-G-5,08_1x02_P5.08mm_Horizontal
R101, R102: 2k2; R_0603_1608Metric

Connections:
+3.3V: R101.1, R102.1; also elsewhere on the board
/Power Measurement/I2C_SCL: R101.2; also elsewhere on the board
/Power Measurement/I2C_SDA: R102.2; also elsewhere on the board
/Vbus1_in: J101.2; also elsewhere on the board
/Vbus2_in: J103.2; also elsewhere on the board
/Vbus2_out: J104.1; also elsewhere on the board
GND: H101.1, H102.1, H103.1, H104.1, J101.1, J102.2, J103.1, J104.2; also elsewhere on the board
VIN: J102.1; also elsewhere on the board

Notes on the sheet:
Goals: - ESP32-C1 based - Support for a 24V LiFePo4 solar system in power and power measurement - Support on board for 0-2 power measurement channels - Support for an optional load cell measurement - Support for a micro-SD card for logging Secondary - Optional support for an LCD - Breakout remainin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
I2C Addresses: - 0x2A - NAU7802 Load Cell Amplifier - 0x44 - SHT4x - 0x46 - INA237 - 1 0x45 on prototype board after modification - 0x47 - INA237 - 2
