benvonhandorf/esp32_sensor_board/hardware/v0/esp32_sensor_board/esp32_sensor_board.kicad_pcb

## KiCad design hardware/v0/esp32_sensor_board/esp32_sensor_board.kicad_pcb (continued)

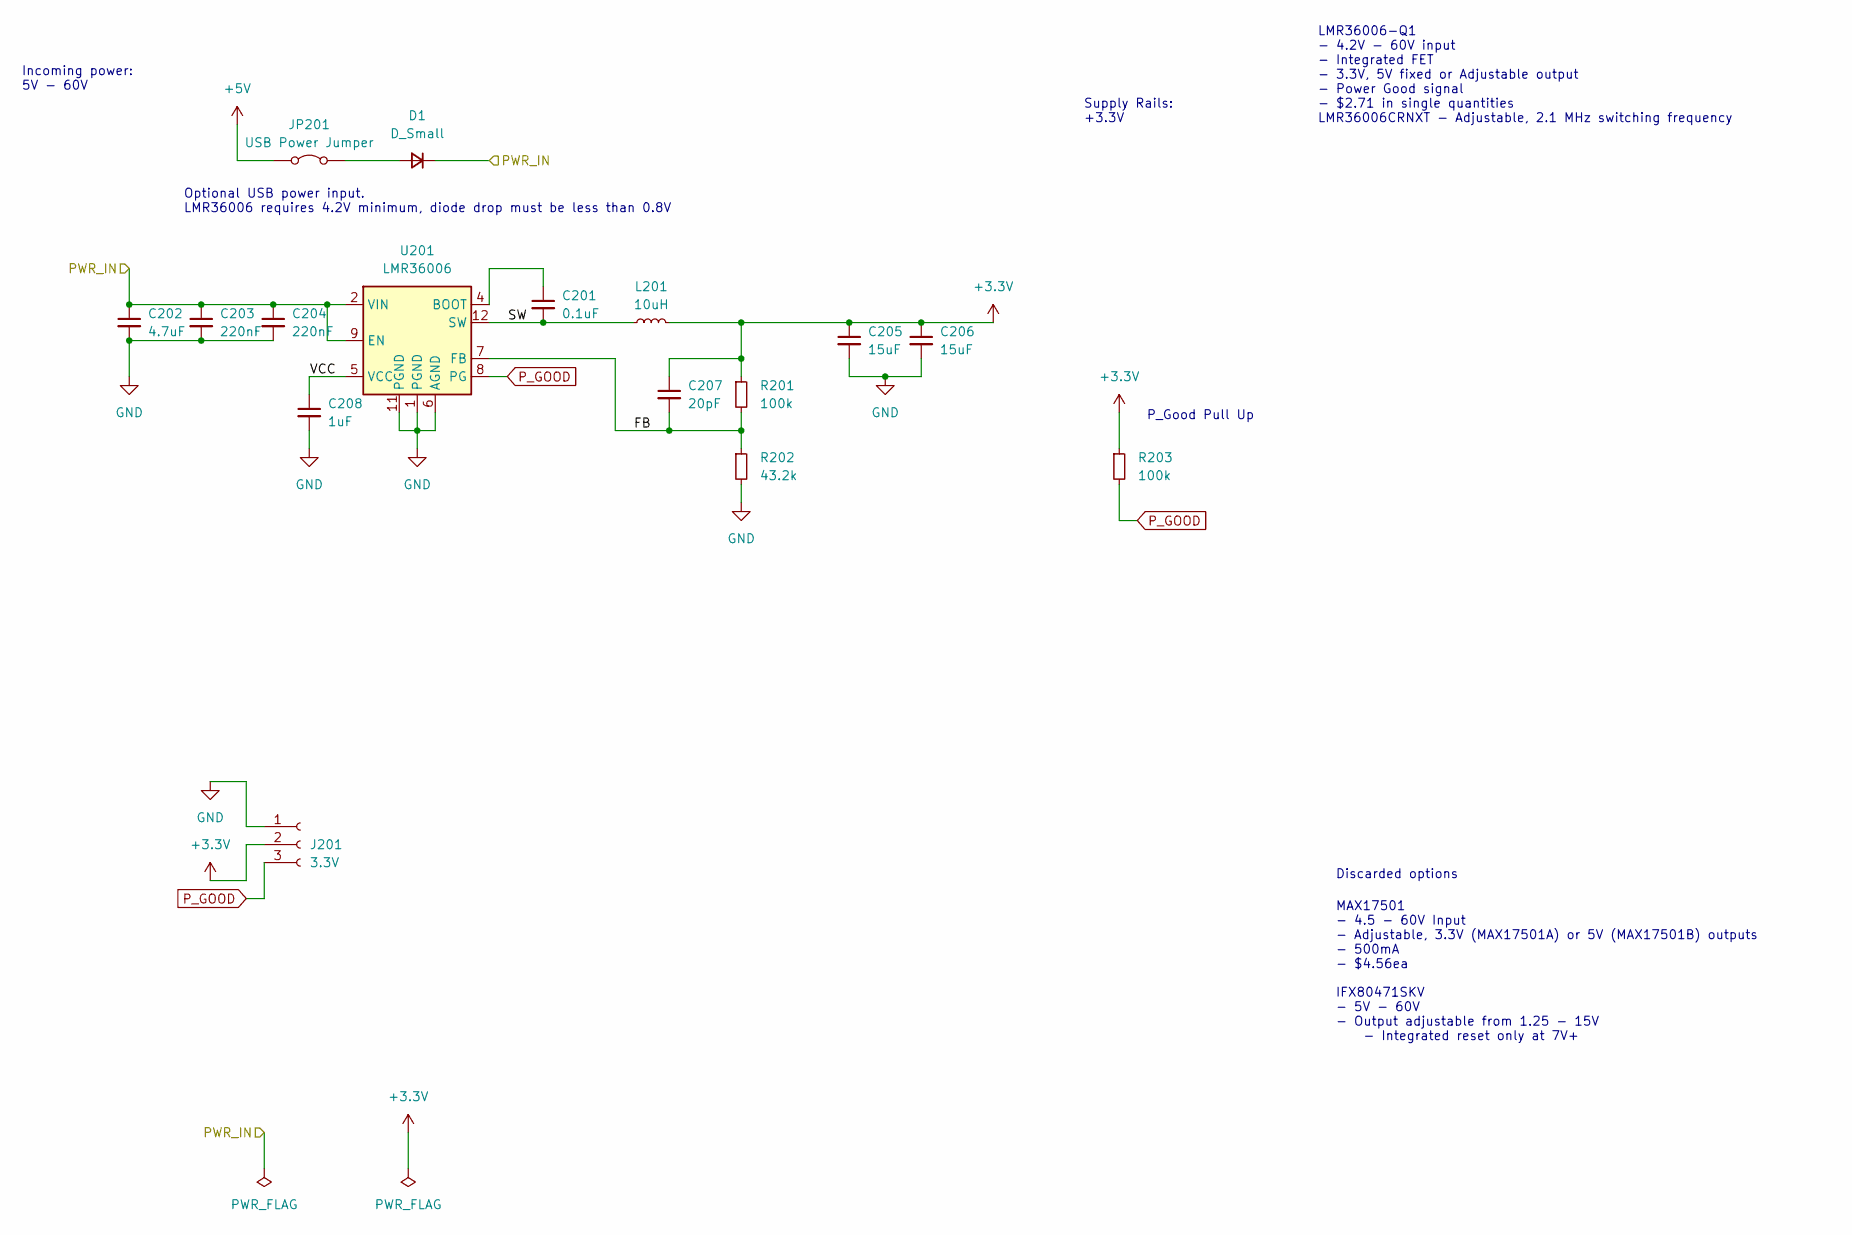
[picture p28: schematic esp32_sensor_power.kicad_sch]

Parts:
C201: 0.1uF; C_0603_1608Metric
C202: 4.7uF; C_1206_3216Metric
C203, C204: 220nF; C_1206_3216Metric
C205, C206: 15uF; C_1206_3216Metric
C207: 20pF; C_0805_2012Metric
C208: 1uF; C_0805_2012Metric
D1: D_Small; D_SOD-123
J201: 3.3V; PinHeader_1x03_P2.54mm_Vertical
JP201: USB Power Jumper; SolderJumper-2_P1.3mm_Bridged_RoundedPad1.0x1.5mm
L201: 10uH; L_Taiyo-Yuden_MD-4040
R201, R203: 100k; R_0603_1608Metric
R202: 43.2k; R_0603_1608Metric
U201: LMR36006; LMR36006-VQFN-HR

Connections:
+3.3V: C205.1, C206.1, C207.1, J201.2, L201.2, R201.1, R203.1; also elsewhere on the board
+5V: JP201.1 (A); also elsewhere on the board
/Power/FB: C207.2, R201.2, R202.1, U201.7 (FB)
/Power/SW: C201.2, L201.1, U201.3 (SW), U201.12 (SW)
/Power/VCC: C208.1, U201.5 (VCC)
GND: C202.2, C203.2, C204.2, C205.2, C206.2, C208.2, J201.1, R202.2, U201.1 (PGND), U201.6 (AGND), U201.11 (PGND); also elsewhere on the board
unnamed: D1.2 (A), JP201.2 (B)
unnamed: C201.1, U201.4 (BOOT)
P_GOOD: J201.3, R203.2, U201.8 (PG)
VIN: C202.1, C203.1, C204.1, D1.1 (K), U201.2 (VIN), U201.9 (EN), U201.10 (VIN); also elsewhere on the board

Notes on the sheet:
MAX17501 - 4.5 - 60V Input - Adjustable, 3.3V (MAX17501A) or 5V (MAX17501B) outputs - 500mA - $4.56ea
LMR36006-Q1 - 4.2V - 60V input - Integrated FET - 3.3V, 5V fixed or Adjustable output - Power Good signal - $2.71 in single quantities LMR36006CRNXT - Adjustable, 2.1 MHz switching frequency
IFX80471SKV - 5V - 60V - Output adjustable from 1.25 - 15V - Integrated reset only at 7V+
P_Good Pull Up
Discarded options
Optional USB power input. LMR36006 requires 4.2V minimum, diode drop must be less than 0.8V
Supply Rails: +3.3V
Incoming power: 5V - 60V

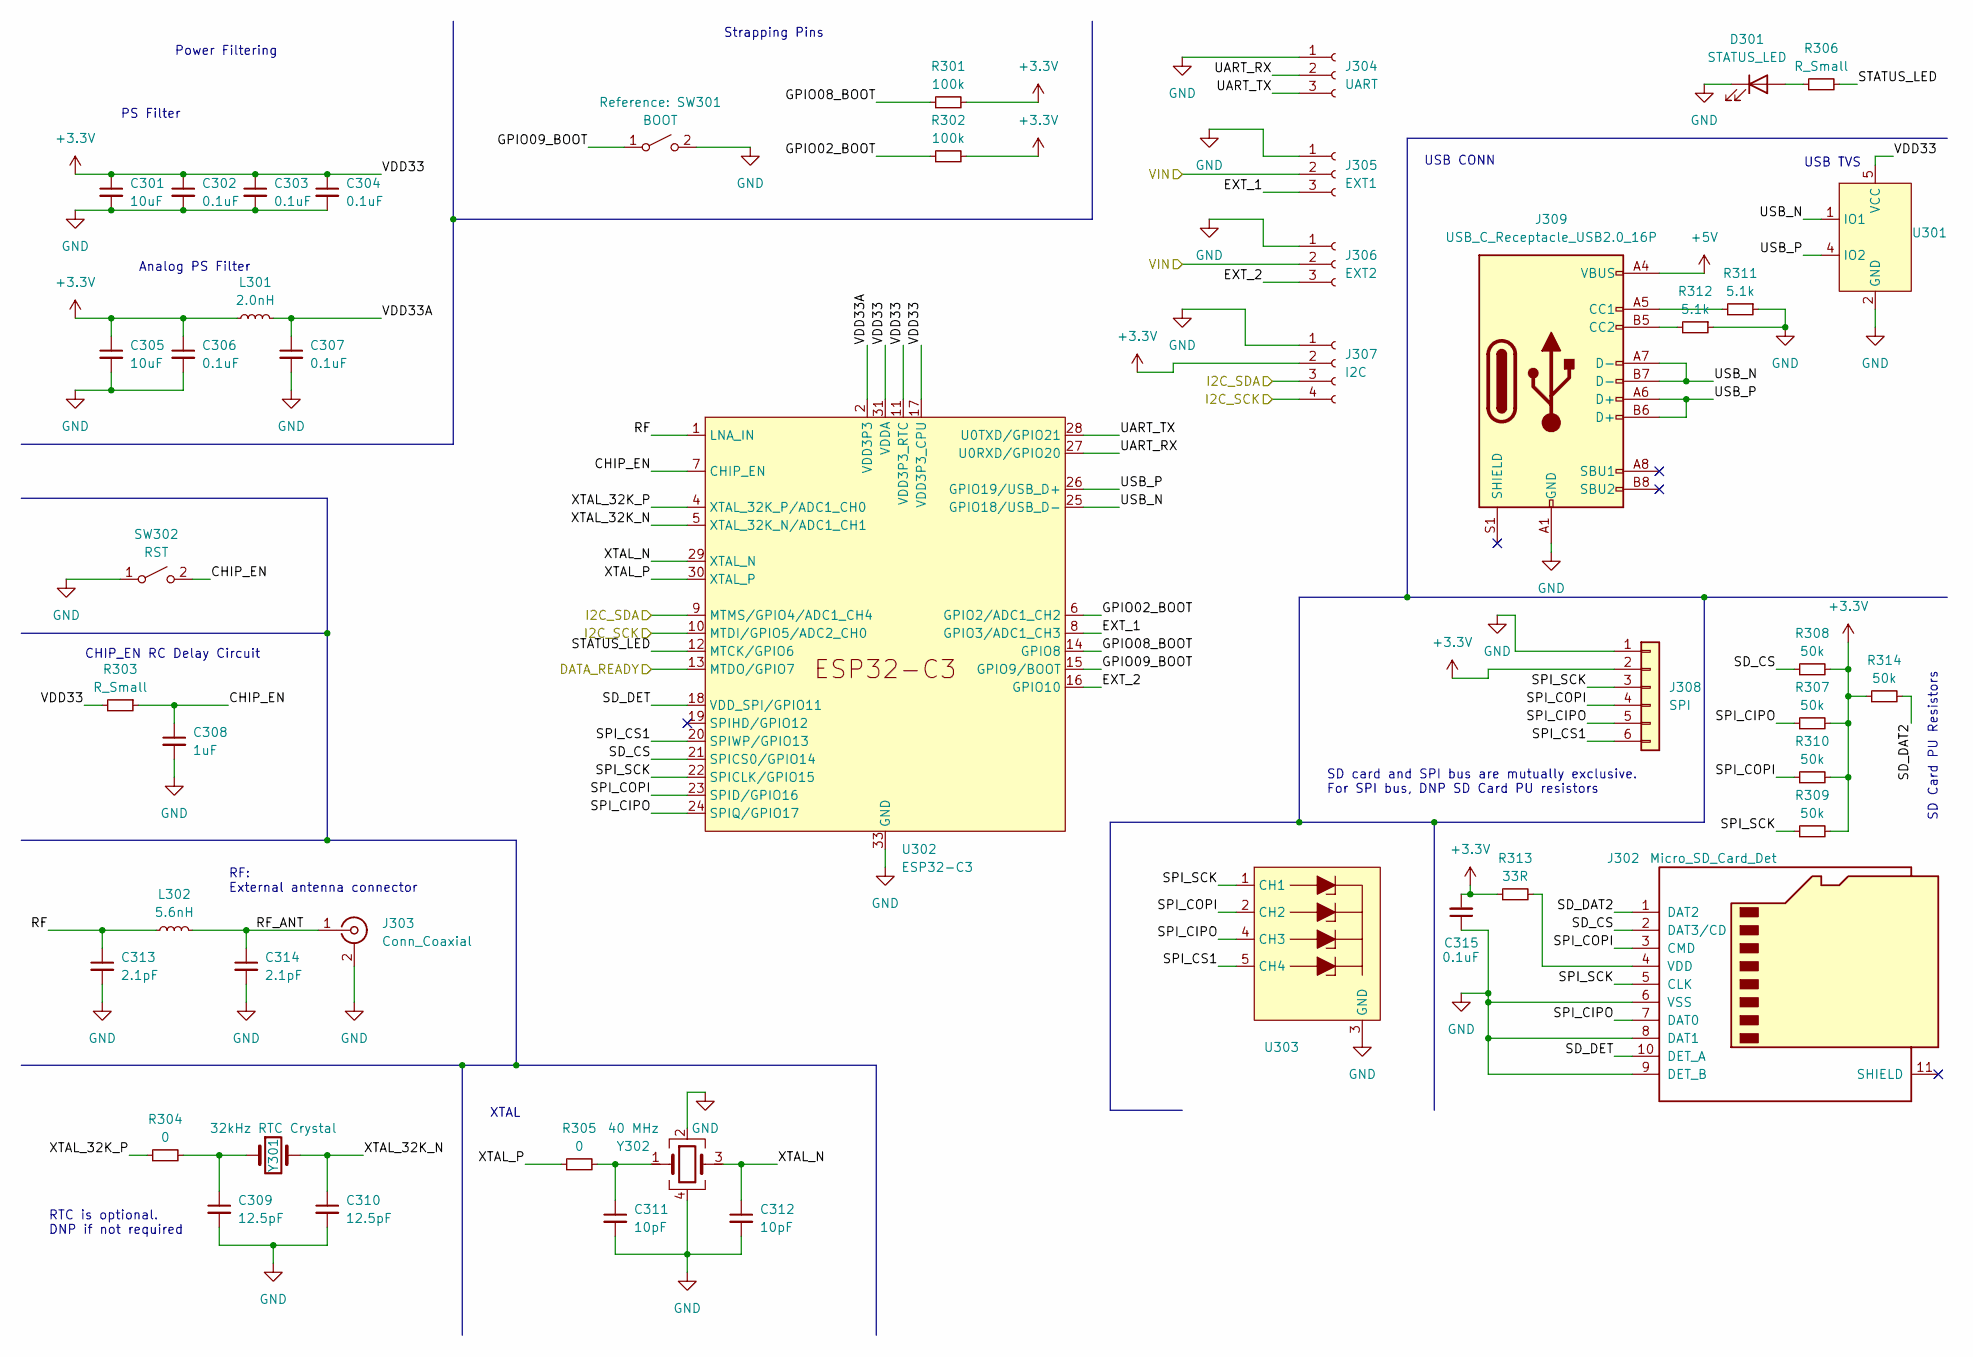
[picture p29: schematic esp32_uc.kicad_sch]

Parts:
C301, C305: 10uF; C_0805_2012Metric
C302, C303, C304, C306, C307, C315: 0.1uF; C_0603_1608Metric
C308: 1uF; C_0805_2012Metric
C309, C310: 12.5pF; C_0603_1608Metric
C311, C312: 10pF; C_0603_1608Metric
C313, C314: 2.1pF; C_0603_1608Metric
D301: STATUS_LED; LED_0805_2012Metric
J302: Micro_SD_Card_Det; MicroSD_Socket_Unbranded
J303: Conn_Coaxial; U.FL_Molex_MCRF_73412-0110_Vertical
J304: UART; PinHeader_1x03_P2.54mm_Vertical
J305: EXT1; PinHeader_1x03_P2.54mm_Vertical
J306: EXT2; PinHeader_1x03_P2.54mm_Vertical
J307: I2C; PinHeader_1x04_P2.54mm_Vertical
J308: SPI; PinHeader_1x06_P2.54mm_Vertical
J309: USB_C_Receptacle_USB2.0_16P; USB_C_Receptacle_GCT_USB4085
L301: 2.0nH; L_0402_1005Metric
L302: 5.6nH; L_0603_1608Metric
R301, R302: 100k; R_0603_1608Metric
R303, R306: R_Small; R_0603_1608Metric
R304, R305: 0; R_0603_1608Metric
R307, R308, R309, R310, R314: 50k; R_0603_1608Metric
R311, R312: 5.1k; R_0603_1608Metric
R313: 33R; R_0603_1608Metric
SW301: BOOT; TacButton_SMD_5mm_5mm
SW302: RST; Tac_SMD_6.4mm_Side_SPST_NO
U301: SOT-23-6
U302: ESP32-C3; QFN-32-1EP_5x5mm_P0.5mm_EP3.45x3.45mm
U303: Diode_10Pin_DFN2510A-10_10-XFDFN_SOT1176-1
Y301: 32kHz RTC Crystal; Crystal_SMD_3215-2Pin_3.2x1.5mm
Y302: 40 MHz; Crystal_SMD_2016-4Pin_2.0x1.6mm

Connections:
+3.3V: C301.1, C302.1, C303.1, C304.1, C305.1, C306.1, C315.2, J307.2, J308.2, L301.1, R301.2, R302.2, R303.2, R307.2, R308.2, R309.2, R310.2, R313.1, R314.1, U301.5 (VCC), U302.11 (VDD3P3_RTC), U302.17 (VDD3P3_CPU), U302.31 (VDDA), U302.32 (VDDA); also elsewhere on the board
+5V: J309.A4 (VBUS), J309.A9 (VBUS), J309.B4 (VBUS), J309.B9 (VBUS); also elsewhere on the board
/Load Cell Sensor/DRDY_NAU: U302.13 (MTDO/GPIO7); also elsewhere on the board
/Microprocessor/CHIP_EN: C308.1, R303.1, SW302.2 (B), U302.7 (CHIP_EN)
/Microprocessor/EXT_1: J305.3, U302.8 (GPIO3/ADC1_CH3)
/Microprocessor/EXT_2: J306.3, U302.16 (GPIO10)
/Microprocessor/GPIO02_BOOT: R302.1, U302.6 (GPIO2/ADC1_CH2)
/Microprocessor/GPIO08_BOOT: R301.1, U302.14 (GPIO8)
/Microprocessor/GPIO09_BOOT: SW301.1 (A), U302.15 (GPIO9/BOOT)
/Microprocessor/RF: C313.1, L302.1, U302.1 (LNA_IN)
/Microprocessor/RF_ANT: C314.1, J303.1 (In), L302.2
/Microprocessor/SD_CS: J302.2 (DAT3/CD), R308.1, U302.21 (SPICS0/GPIO14)
/Microprocessor/SD_DAT2: J302.1 (DAT2), R314.2
/Microprocessor/SD_DET: J302.10 (DET_A), U302.18 (VDD_SPI/GPIO11)
/Microprocessor/SPI_CIPO: J302.7 (DAT0), J308.5, R307.1, U302.24 (SPIQ/GPIO17), U303.4 (CH3)
/Microprocessor/SPI_COPI: J302.3 (CMD), J308.4, R310.1, U302.23 (SPID/GPIO16), U303.2 (CH2)
/Microprocessor/SPI_CS1: J308.6, U302.20 (SPIWP/GPIO13), U303.5 (CH4)
/Microprocessor/SPI_SCK: J302.5 (CLK), J308.3, R309.1, U302.22 (SPICLK/GPIO15), U303.1 (CH1)
/Microprocessor/STATUS_LED: R306.2, U302.12 (MTCK/GPIO6)
/Microprocessor/UART_RX: J304.2, U302.27 (U0RXD/GPIO20)
/Microprocessor/UART_TX: J304.3, U302.28 (U0TXD/GPIO21)
/Microprocessor/USB_N: J309.A7 (D-), J309.B7 (D-), U301.1 (IO1), U302.25 (GPIO18/USB_D-)
/Microprocessor/USB_P: J309.A6 (D+), J309.B6 (D+), U301.4 (IO2), U302.26 (GPIO19/USB_D+)
/Microprocessor/VDD33A: C307.1, L301.2, U302.2 (VDD3P3), U302.3 (VDD3P3)
/Microprocessor/XTAL_32K_N: C310.1, U302.5 (XTAL_32K_N/ADC1_CH1), Y301.2
/Microprocessor/XTAL_32K_P: R304.1, U302.4 (XTAL_32K_P/ADC1_CH0)
/Microprocessor/XTAL_N: C312.1, U302.29 (XTAL_N), Y302.3
/Microprocessor/XTAL_P: R305.1, U302.30 (XTAL_P)
/Power Measurement/I2C_SCL: J307.4, U302.10 (MTDI/GPIO5/ADC2_CH0); also elsewhere on the board
/Power Measurement/I2C_SDA: J307.3, U302.9 (MTMS/GPIO4/ADC1_CH4); also elsewhere on the board
GND: C301.2, C302.2, C303.2, C304.2, C305.2, C306.2, C307.2, C308.2, C309.2, C310.2, C311.2, C312.2, C313.2, C314.2, C315.1, D301.1 (K), J302.6 (VSS), J302.8 (DAT1), J302.9 (DET_B), J303.2 (Ext), J304.1, J305.1, J306.1, J307.1, J308.1, J309.A1 (GND), J309.A12 (GND), J309.B1 (GND), J309.B12 (GND), R311.1, R312.1, SW301.2 (B), SW302.1 (A), U301.2 (GND), U302.33 (GND), U303.3 (GND), U303.8 (GND), Y302.2, Y302.4; also elsewhere on the board
unnamed: C309.1, R304.2, Y301.1
unnamed: C311.1, R305.2, Y302.1
unnamed: D301.2 (A), R306.1
unnamed: J302.4 (VDD), R313.2
unnamed: J309.A5 (CC1), R311.2
unnamed: J309.B5 (CC2), R312.2
VIN: J305.2, J306.2; also elsewhere on the board

Notes on the sheet:
CHIP_EN RC Delay Circuit
Analog PS Filter
SD Card PU Resistors
XTAL
USB CONN
SD card and SPI bus are mutually exclusive. For SPI bus, DNP SD Card PU resistors
RTC is optional. DNP if not required
USB TVS
Strapping Pins
Power Filtering
PS Filter
RF: External antenna connector

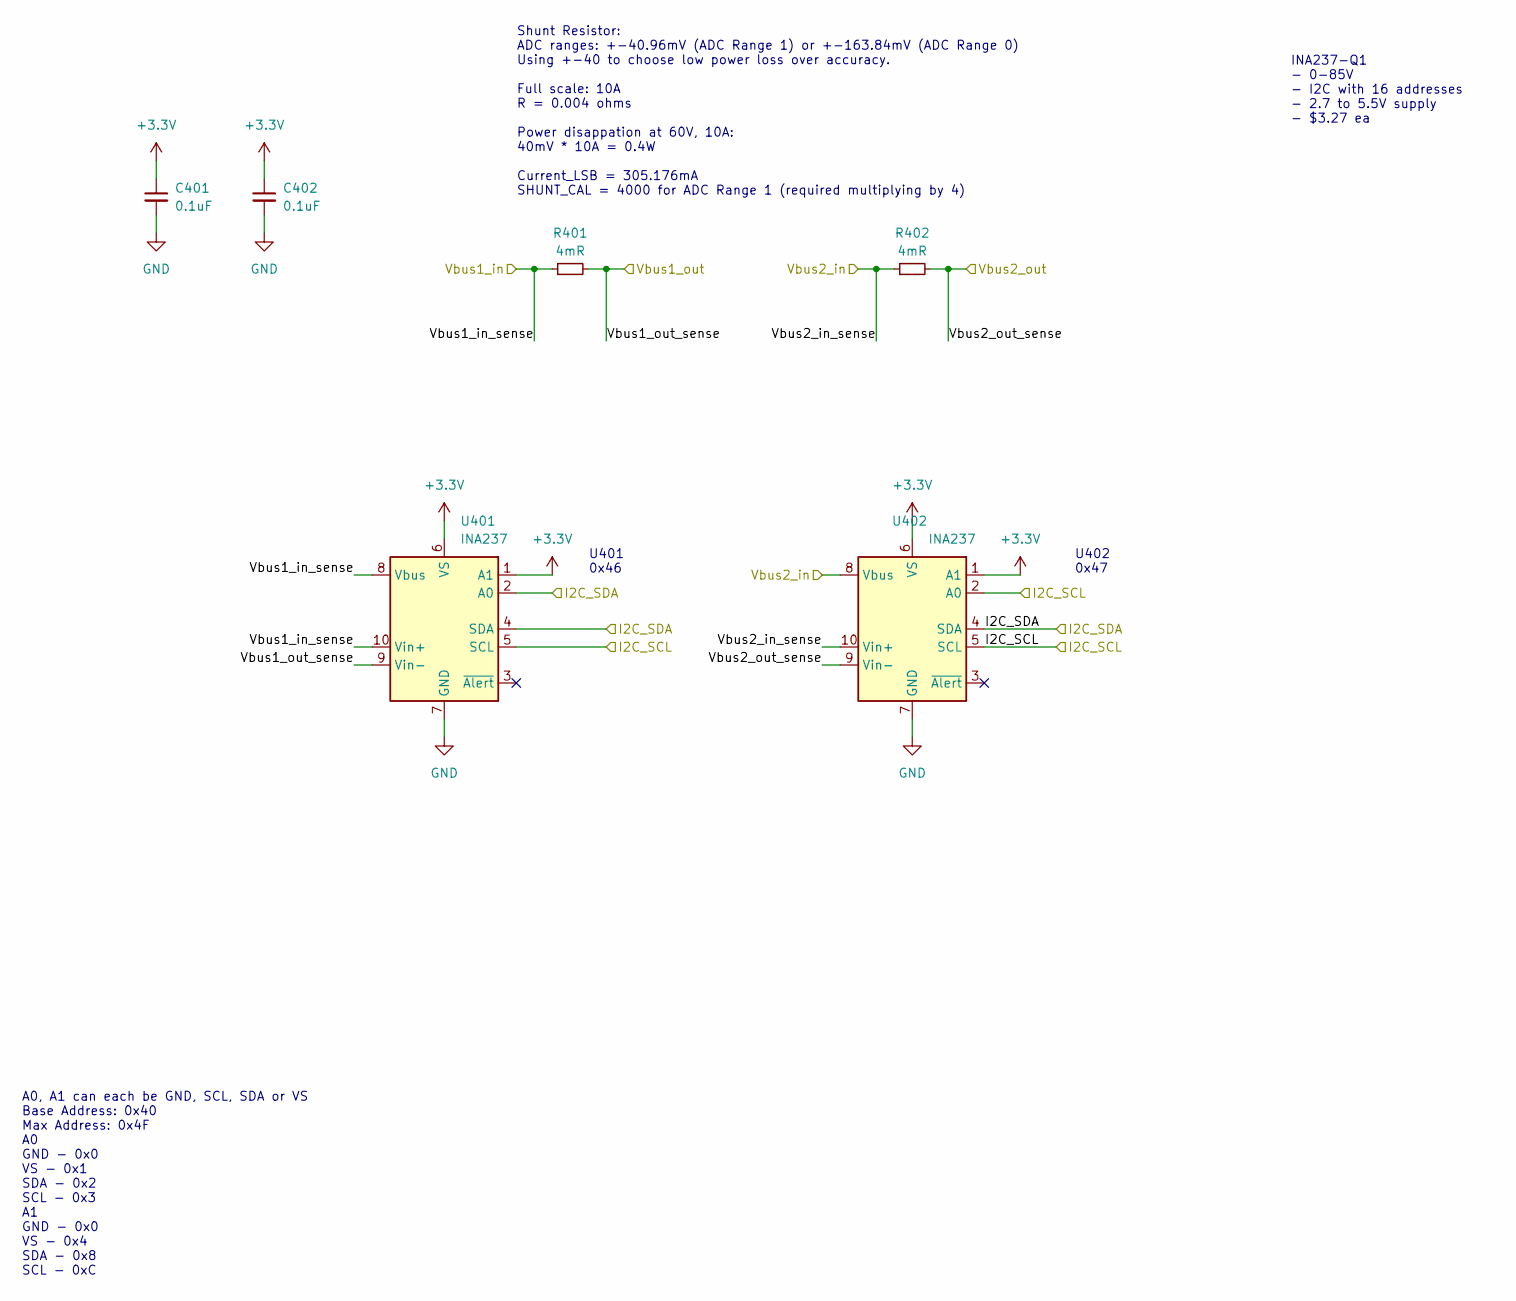
[picture p30: schematic sensor_power_measurement.kicad_sch]

Parts:
C401, C402: 0.1uF; C_0603_1608Metric
R401, R402: 4mR; R_2512_6332Metric
U401, U402: INA237; VSSOP-10_3x3mm_P0.5mm

Connections:
+3.3V: C401.1, C402.1, U401.1 (A1), U401.6 (VS), U402.1 (A1), U402.6 (VS); also elsewhere on the board
/Power Measurement/I2C_SCL: U401.5 (SCL), U402.2 (A0), U402.5 (SCL); also elsewhere on the board
/Power Measurement/I2C_SDA: U401.2 (A0), U401.4 (SDA), U402.4 (SDA); also elsewhere on the board
/Vbus1_in: R401.1, U401.8 (Vbus), U401.10 (Vin+); also elsewhere on the board
/Vbus2_in: R402.1, U402.8 (Vbus), U402.10 (Vin+); also elsewhere on the board
/Vbus2_out: R402.2, U402.9 (Vin-); also elsewhere on the board
GND: C401.2, C402.2, U401.7 (GND), U402.7 (GND); also elsewhere on the board
VIN: R401.2, U401.9 (Vin-); also elsewhere on the board

Notes on the sheet:
INA237-Q1 - 0-85V - I2C with 16 addresses - 2.7 to 5.5V supply - $3.27 ea
U402 0x47
Shunt Resistor: ADC ranges: +-40.96mV (ADC Range 1) or +-163.84mV (ADC Range 0) Using +-40 to choose low power loss over accuracy. Full scale: 10A R = 0.004 ohms Power disappation at 60V, 10A: 40mV * 10A = 0.4W Current_LSB = 305.176mA SHUNT_CAL = 4000 for ADC Range 1 (required multiplying by 4)
U401 0x46
A0, A1 can each be GND, SCL, SDA or VS Base Address: 0x40 Max Address: 0x4F A0 GND - 0x0 VS - 0x1 SDA - 0x2 SCL - 0x3 A1 GND - 0x0 VS - 0x4 SDA - 0x8 SCL - 0xC


Parts:
C601: 1uF; C_0805_2012Metric
U601: SHT4x; Sensirion_DFN-4_1.5x1.5mm_P0.8mm_SHT4x_NoCentralPad

Connections:
+3.3V: C601.1, U601.3 (VDD); also elsewhere on the board
/Power Measurement/I2C_SCL: U601.2 (SCL); also elsewhere on the board
/Power Measurement/I2C_SDA: U601.1 (SDA); also elsewhere on the board
GND: C601.2, U601.4 (VSS); also elsewhere on the board

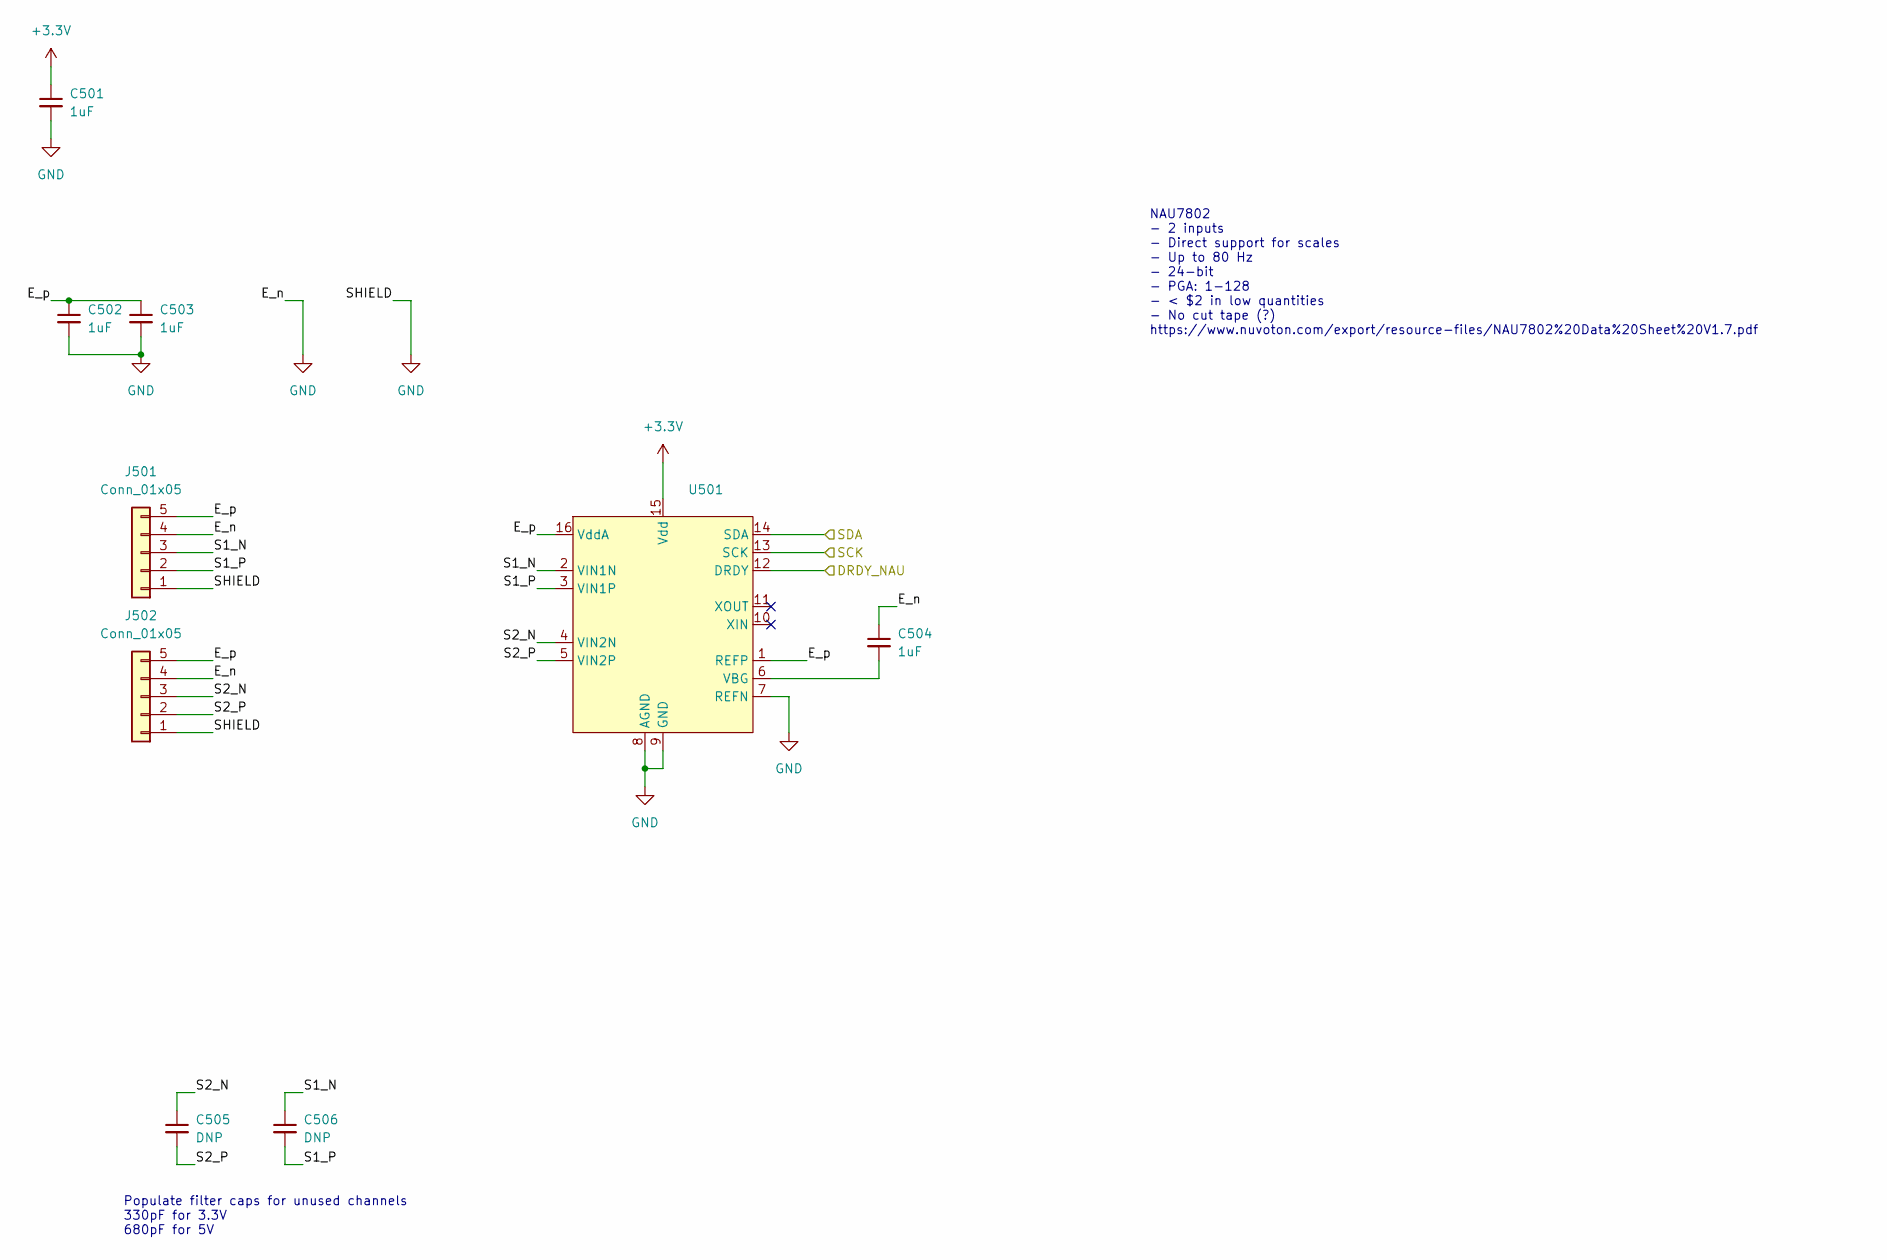
[picture p31: schematic sensor_loadcell.kicad_sch]

Parts:
C501, C502, C503, C504: 1uF; C_0805_2012Metric
C505, C506: DNP; C_0805_2012Metric
J501, J502: Conn_01x05; PinHeader_1x05_P2.54mm_Horizontal
U501: SOIC-16_3.9x9.9mm_P1.27mm

Connections:
+3.3V: C501.1, U501.15 (Vdd); also elsewhere on the board
/Load Cell Sensor/DRDY_NAU: U501.12 (DRDY); also elsewhere on the board
/Load Cell Sensor/E_p: C502.1, C503.1, J501.5, J502.5, U501.1 (REFP), U501.16 (VddA)
/Load Cell Sensor/S1_N: C506.1, J501.3, U501.2 (VIN1N)
/Load Cell Sensor/S1_P: C506.2, J501.2, U501.3 (VIN1P)
/Load Cell Sensor/S2_N: C505.1, J502.3, U501.4 (VIN2N)
/Load Cell Sensor/S2_P: C505.2, J502.2, U501.5 (VIN2P)
/Power Measurement/I2C_SCL: U501.13 (SCK); also elsewhere on the board
/Power Measurement/I2C_SDA: U501.14 (SDA); also elsewhere on the board
GND: C501.2, C502.2, C503.2, C504.1, J501.1, J501.4, J502.1, J502.4, U501.7 (REFN), U501.8 (AGND), U501.9 (GND); also elsewhere on the board
unnamed: C504.2, U501.6 (VBG)

Notes on the sheet:
NAU7802 - 2 inputs - Direct support for scales - Up to 80 Hz - 24-bit - PGA: 1-128 - < $2 in low quantities - No cut tape (?) https://www.nuvoton.com/export/resource-files/NAU7802%20Data%20Sheet%20V1.7.pdf
Populate filter caps for unused channels 330pF for 3.3V 680pF for 5V

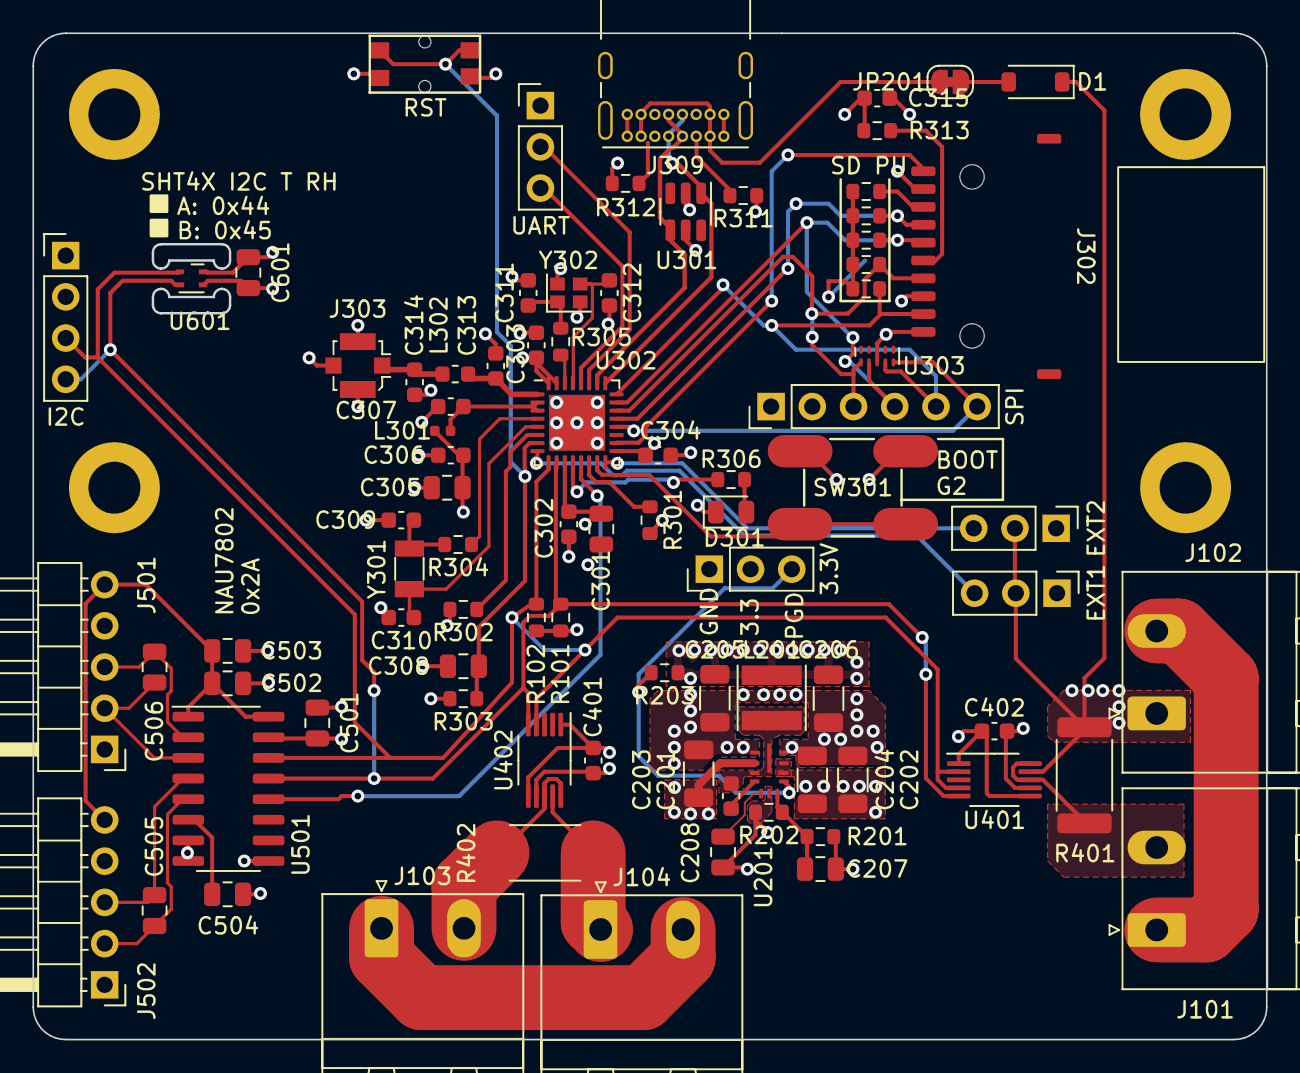
[picture p32: board esp32_sensor_board.kicad_pcb from above]

Board: 4 copper layers, 76.0 x 62.0 mm, 90 parts (0 on the bottom side), 53 nets.
