benvonhandorf/esp32_sensor_board/hardware/relay_board/relay_board.kicad_pcb

## KiCad design hardware/relay_board/relay_board.kicad_pcb (2023-10-31)

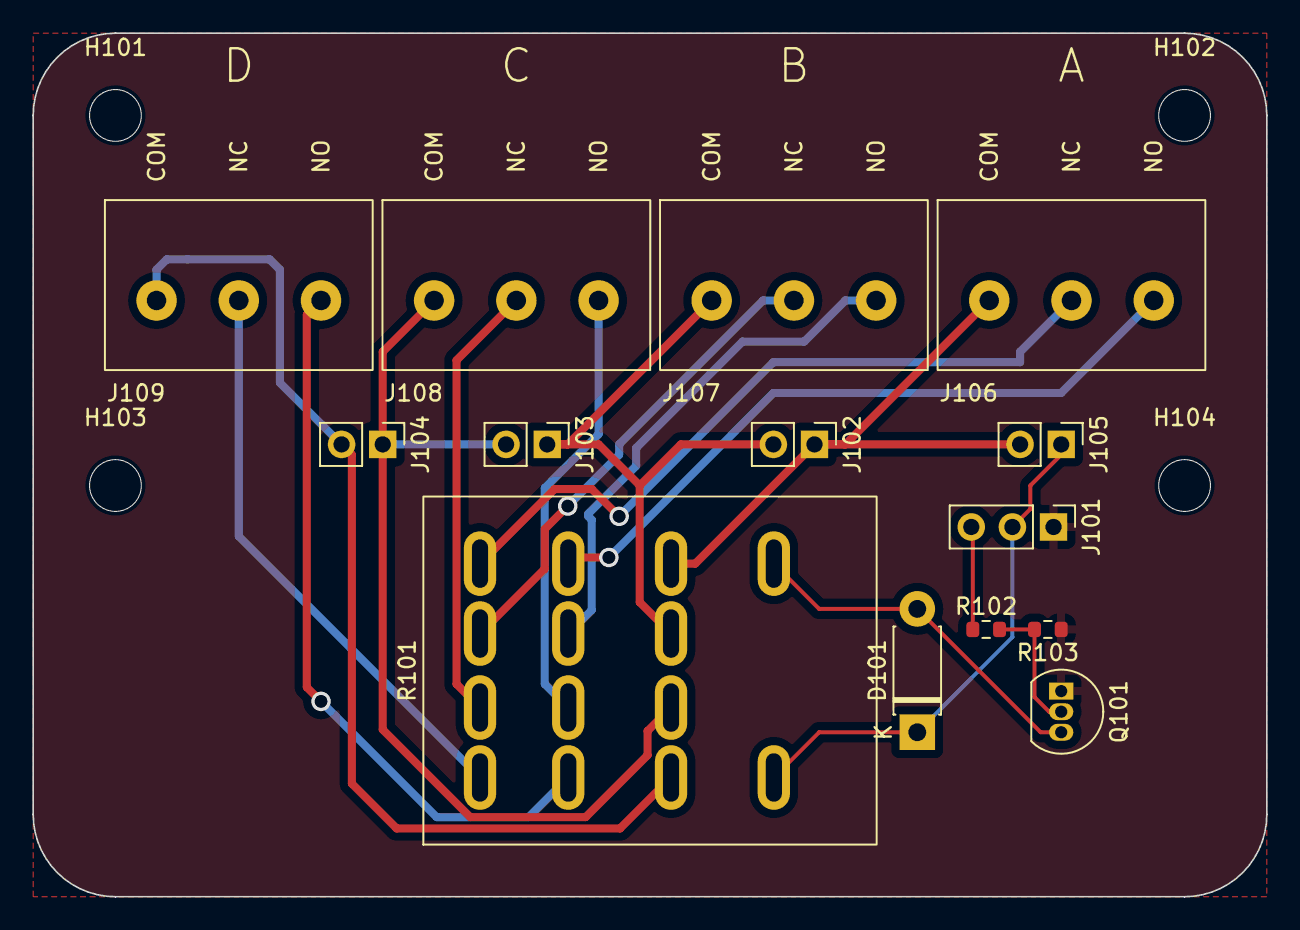
[picture p33: board relay_board.kicad_pcb from above]

Board: 2 copper layers, 76.2 x 53.3 mm, 18 parts (0 on the bottom side), 17 nets.

Parts:
D101: D; D_DO-41_SOD81_P7.62mm_Horizontal
H101, H102, H103, H104: MountingHole; MountingHole_3.2mm_M3
J101: Conn_01x03_Pin; PinHeader_1x03_P2.54mm_Vertical
J102: A - B; PinHeader_1x02_P2.54mm_Vertical
J103: B - C; PinHeader_1x02_P2.54mm_Vertical
J104: C - D; PinHeader_1x02_P2.54mm_Vertical
J105: VIN - A; PinHeader_1x02_P2.54mm_Vertical
J106: A; 5.08mm_THT_PinHeader_01x03
J107: B; 5.08mm_THT_PinHeader_01x03
J108: C; 5.08mm_THT_PinHeader_01x03
J109: D; 5.08mm_THT_PinHeader_01x03
Q101: 2N7000; TO-92_Inline
R101: OMRON_MY4
R102: 1k; R_0603_1608Metric
R103: 100k; R_0603_1608Metric

Connections:
/COM_A: J102.1, J105.2, J106.1, R101.9 (COM)
/COM_B: J102.2, J103.1, J107.1, R101.10 (COM)
/COM_C: J103.2, J104.1, J108.1, R101.11 (COM)
/COM_D: J104.2, J109.1, R101.12 (COM)
/NC_A: J106.2, R101.1 (NC)
/NC_B: J107.2, R101.2 (NC)
/NC_C: J108.2, R101.3 (NC)
/NC_D: J109.2, R101.4 (NC)
/NO_A: J106.3, R101.5 (NO)
/NO_B: J107.3, R101.6 (NO)
/NO_C: J108.3, R101.7 (NO)
/NO_D: J109.3, R101.8 (NO)
/SIG: J101.3, R102.1
GND: J101.1, Q101.1 (S), R103.1
unnamed: D101.2 (A), Q101.3 (D), R101.13 (-)
unnamed: Q101.2 (G), R102.2, R103.2
VSS: D101.1 (K), J101.2, J105.1, R101.14 (+)
