benvonhandorf/esp32_sensor_board/firmware/rust/bringup/intro/src/wifi_config.rs

pub struct WifiConfiguration {
    pub ssid: str,
    pub psk: str,
}

pub const WIFI_CONFIGURATION : WifiConfiguration =
    WifiConfiguration {
        ssid: "Oblivion",
        psk: "t4unjath0mson",
    };
