benvonhandorf/esp32_sensor_board/firmware/rust/ina237/src/commands.rs

enum Registers {
    CONFIG = 0x00,
    ADC_CONFIG = 0x01,
    SHUNT_CAL = 0x02
    VSHUNT = 0x04,
    VBUS = 0x05,
    DIETEMP = 0x06,
    CURRENT = 0x07,
    POWER = 0x08,
    DIAG_ALRT = 0x08,
    SOVL = 0x0C,
    SUVL = 0x0D,
    BOVL = 0x0E,
    BUVOL = 0x0F,
    TEMP_LIMIT = 0x10,
    PWR_LIMIT = 0x11,
    MANUFACTURER_ID = 0x3E,
}
