benvonhandorf/esp32_sensor_board/(commit log)

2023-07-20 Schematic WIP
    [esp32_sensor_board.kicad_pcb, esp32_sensor_board.kicad_sch, esp32_sensor_power.kicad_sch, esp32_uc.kicad_sch, sensor_loadcell.kicad_sch, sensor_power_measurement.kicad_sch]
2023-07-20 Clean up errors
    [esp32_sensor_power.kicad_sch, esp32_uc.kicad_sch, sensor_loadcell.kicad_sch]
2023-08-14 PCB ordered, a few initial mistakes fixed
    [esp32_sensor_board-B_Cu.gbr, esp32_sensor_board-B_Mask.gbr, esp32_sensor_board-B_Paste.gbr, esp32_sensor_board-B_Silkscreen.gbr, esp32_sensor_board-Edge_Cuts.gbr, esp32_sensor_board-F_Cu.gbr, esp32_sensor_board-F_Mask.gbr, esp32_sensor_board-F_Paste.gbr]
2023-08-14 Rust board bringup WIP
2023-10-16 Board refactor WIP. Still needs PU resistors
    [cmn_crt_authorities.csv, esp32_netsuite.cfg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]
2023-10-24 TVS and PU work
    [esp32_sensor_board.kicad_pcb, esp32_sensor_board.kicad_sch, esp32_uc.kicad_sch]
2023-10-31 Relay board, firmware tests
    [esp32_sensor_board-B_Cu.gbr, esp32_sensor_board-B_Mask.gbr, esp32_sensor_board-B_Silkscreen.gbr, esp32_sensor_board-Edge_Cuts.gbr, esp32_sensor_board-F_Adhesive.gbr, esp32_sensor_board-F_Cu.gbr, esp32_sensor_board-F_Mask.gbr, esp32_sensor_board-F_Paste.gbr]
2024-06-02 INA237 progress, SHT4X comms working
    [esp32_sensor_board.kicad_pcb, esp32_sensor_board.kicad_sch, esp32_sensor_power.kicad_sch, esp32_uc.kicad_sch, sensor_loadcell.kicad_sch, sensor_power_measurement.kicad_sch, temp_humidity.kicad_sch]
2024-06-20 Current unit fix
    [sensor_power_measurement.kicad_sch]
2024-07-05 NAU7802 ADC working
2024-07-06 Clean up driver crate warnings
2024-07-11 WIP v3 hardware
    [USB4510-03-1-A_REVA.step, esp32_sensor_board.kicad_pcb, esp32_sensor_power.kicad_sch, esp32_uc.kicad_sch]
2024-10-20 Output files
    [esp32_sensor_board-B_Cu.gbr, esp32_sensor_board-B_Mask.gbr, esp32_sensor_board-B_Paste.gbr, esp32_sensor_board-B_Silkscreen.gbr, esp32_sensor_board-Edge_Cuts.gbr, esp32_sensor_board-F_Adhesive.gbr, esp32_sensor_board-F_Cu.gbr, esp32_sensor_board-F_Mask.gbr]
2024-11-28 Layout WIP
    [esp32_sensor_board.kicad_pcb]
2025-01-12 Revisions for recordering
    [esp32_sensor_board-B_Cu.gbr, esp32_sensor_board-B_Mask.gbr, esp32_sensor_board-B_Paste.gbr, esp32_sensor_board-B_Silkscreen.gbr, esp32_sensor_board-Edge_Cuts.gbr, esp32_sensor_board-F_Adhesive.gbr, esp32_sensor_board-F_Cu.gbr, esp32_sensor_board-F_Mask.gbr]
2026-09-15 v1 board started
    [esp32_sensor_power.kicad_sch, esp32_uc.kicad_sch, s3_sensor_board.kicad_pcb, s3_sensor_board.kicad_sch, sensor_loadcell.kicad_sch, sensor_power_measurement.kicad_sch, temp_humidity.kicad_sch]
2026-09-20 Processor placement and routing work
    [esp32_uc.kicad_sch, pdm_mics.kicad_sch, s3_sensor_board.kicad_pcb, sensor_loadcell.kicad_sch]
2026-09-23 Layout, starting DRC
    [esp32_uc.kicad_sch, s3_sensor_board.kicad_pcb, s3_sensor_board.kicad_sch]
2026-09-24 S3 WIP - Initial submission
    [esp32_uc.kicad_sch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]
2026-09-24 WIP, standoffs
    [loadcell_fanout.kicad_pcb, s3_sensor_board.kicad_pcb]
2026-09-25 WIP Fanout Board
    [pdm_fanout.kicad_pcb, pdm_fanout.kicad_sch, s3_sensor_board.kicad_pcb]
2026-09-26 Standoff move, silkscreen work
    [loadcell_fanout.kicad_pcb, loadcell_fanout.kicad_sch, pdm_fanout.kicad_pcb, pdm_fanout.kicad_sch, s3_sensor_board.kicad_pcb, s3_sensor_board.kicad_sch]
2026-09-26 WIP Text Work
    [s3_sensor_board.kicad_pcb]
2026-09-26 Add mic board
    [pdm_mic_board_individual.kicad_pcb, pdm_mic_board_individual.kicad_sch]
